355911097/gatewayapp/Hw/trunk/Project/Readme.Txt

2015-8-10 Rev1.00:   建立版本
2015-8-30 Rev2.00:   

1.修改为4通道电池
2.修正了采样sch错误的bug

2016-1-22 Rev2.01
修正1117引脚封装错位的问题
修正mos驱动电路增加IO的上拉电阻

V3.00
主控芯片换成MSP430
电源芯片采用升降压的TPS63000
电流采样采用INA213，降低测量时候的电压损耗

V3.10
修改Lux接口为数字接口
增加硬件看门狗

V4.00
充放电抽象出独立的板 3043-1-1550
修改Lux接口接插件为1.0间距，为了方便加工线缆
修改EEPROM的地址0xA0为0xA4
增加SPIFLASH接口
修改P2接插件
增加模拟Lux接口
