355911097/gatewayapp/doc/物联网网关/神州金山--物联网网关--产品测试任务书.docx

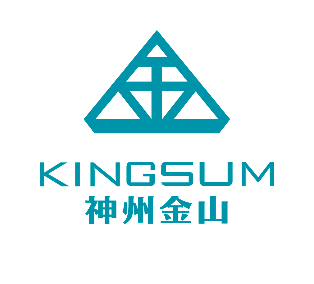
[picture p1: figure]

| 神州金山 技术文档 | 文件编号：SZJS-TEC-ZD-1708-001 页数： 版本：

消防物联网技术方案

拟制 | 王中亚 | 日期 | 2017/3/5
评审 | | 日期
批准 | | 日期

神州金山物联网科技（上海）有限公司

以上信息解释权归神州金山所有 | 打印件及电子版不受控，同效力使用

修订记录

日期 | 修订版本 | 编号 | 修改章节 | 修改内容 | 作者

# 目录

# 1 概述

消防物联网网关是一种远程监控、远程控制和数据采集的单元装置，它将成为消防的一些终端设备与互联网的通信纽带，将传统消防的人工监控控制转变为平台监控控制。消防主机、传感器、消防风机、水泵等消防设接入到消防物联网网关，物联网网接入到平台，可以实现通过平台监控各个设备的状态，并实现远程控制。

# 2 背景

# 3 主要技术指标

## 3.1 硬件配置

## 3.2 机械规格

外壳防护试验要求达到IEC60529机箱防护等级规定的IP54。

## 3.3 环境

- 温度和湿度
- 运行 -35℃ ~ +55℃温度

0 ~ 90% 湿度

- 存储 -35℃ ~ +70℃温度

0 ~ 90% 湿度

- 冲击和震动
- 冲击 半正弦波，50g，方向：X、Y、Z
- 震动 2~100Hz，7m/s² ，方向：X、Y、Z

## 3.4 网关和服务器通信

- 响应延迟：≤0.5s
- 数据包大小：≤512bytes
- 数据包间隔：≥0.5s

# 4 硬件环境

# 5 软件环境

Keil_V5.1

+Micrium_STM3220G-Eval_uCOS-III

+STM32F2xx_StdPeriph_Lib_V1.1.0库

+STM32F2x7_ETH_Driver_V1.1.0

+LWIP_V2.3

+C语言

## 5.1 Keil

Keil C51是美国Keil Software公司出品的51系列兼容单片机C语言软件开发系统，与汇编相比，C语言在功能上、结构性、可读性、可维护性上有明显的优势，因而易学易用。Keil提供了包括C编译器、宏汇编、链接器、库管理和一个功能强大的仿真调试器等在内的完整开发方案，通过一个集成开发环境（μVision）将这些部分组合在一起。运行Keil软件需要WIN98、NT、WIN2000、WINXP等操作系统。如果你使用C语言编程，那么Keil几乎就是你的不二之选，即使不使用C语言而仅用汇编语言编程，其方便易用的集成环境、强大的软件仿真调试工具也会令你事半功倍

## 5.2 Micrium_STM3220G-Eval_uCOS-III

uC/OS-III(Micro C OS Three 微型的C 语言编写的操作系统第3版)是一个可升级的，可固化的，基于优先级的实时内核。它对任务的个数无限制。uC/OS-III 是一个第3 代的系统内核，支持现代的实时内核所期待的大部分功能。例如资源管理，同步，任务间的通信等等。然而，uC/OS-III 提供的特色功能在其它的实时内核中是找不到的，比如说完备的运行时间测量性能，直接地发送信号或者消息到任务，任务可以同时等待多个内核对象等

## 5.3 STM32F2xx_StdPeriph_Lib_V1.1.0

STM32官方提供的关于STM32F2xx系列微控制器的外设固件函数库。该函数库是一个固件函数包，它由程序、数据结构和宏组成，包括了微控制器所有外设的性能特征。该函数库还包括每一个外设的驱动描述和应用实例。通过使用本固件函数库，无需深入掌握细节，用户也可以轻松应用每一个外设。因此，使用本固态函数库可以大大减少用户的程序编写时间，进而降低开发成本。

## 5.4 STM32F2x7_ETH_Driver_V1.1.0

STM32F2x7_ETH_ _V 是LwIP公司提供关于STM32F2xx系统微控制器的Light Weight (轻型)IP协议，有无操作系统的支持都可以运行。LwIP实现的重点是在保持TCP协议主要功能的基础上减少对RAM 的占用，它只需十几KB的RAM和40K左右的ROM就可以运行，这使LwIP协议栈适合在低端的嵌入式系统中使用。

## 5.5 LWIP_V2.3

STM32F2x7_ETH_ _V 是LwIP公司提供关于STM32F2xx系统微控制器的Light Weight (轻型)IP协议，有无操作系统的支持都可以运行。LwIP实现的重点是在保持TCP协议主要功能的基础上减少对RAM 的占用，它只需十几KB的RAM和40K左右的ROM就可以运行，这使LwIP协议栈适合在低端的嵌入式系统中使用。

# 6 设计方案

## 6.1 设计思想及原理

## 6.2 硬件设计

## 6.3 软件设计

物联网网关系统分为三个程序，一个是BootLoader程序，一个Downloader程序，一个是应用程序。

### 6.3.1 升级方式

### 6.3.2 系统运行流程图

### 6.3.3 BootLoader程序

BootLoader程序负责跳转，正常情况下会跳转到APP程序，当需要下载程序的时候会跳转到Downloader程序。

### 6.3.4 DownLoader程序

Downloader程序是用来下来APP程序，当我们需要更新APP程序的时候，Downloader程序会从平台把APP程序下载下来，校验成功后会执行更新，把之前的APP程序替换掉。

### 6.3.5 APP程序

APP程序为物联网网关的主程序，主要负责网关需求上面的全部功能。

### 6.3.6 FLASH分区

针对FLASH分三个区，一个区用来存放BootLoader程序，一个区用来存放下载程序，一个用来存放应用程序。

### 6.3.7 通信方式

#### 6.3.7.1 网关和平台通信方式

网关的数据传输可以通过无线方式和有线方式，网关集成了GPRS和Ethernet接口，网关可以接入到Internet网络，可以把数据传输到平台。

#### 6.3.7.2 网关和消防设备的通信方式

每个网关都会有多路RS485接口和RS232接口，不同多个消防设备可以通过RS485或RS232连接到一个网关，网关和消防设备之间的数据交互通过RS485或RS232。每个消防的设备的通信协议不同，网关要支持多种通信协议。

#### 6.3.7.3 通信协议

### 6.3.8 网关和平台通信协议

# 7 成本核算

请参照物料 KS-WL-WG-04-01.xlsx

# 8 测试

测试分为四个部分，外观测试、性能测试、整机测试和单元测试

## 8.1 外观测试

## 8.2 性能测试

## 8.3 整机测试

## 8.4 单元测试

# 9 调试和维护

神州金山物联网科技（上海）有限公司
