355911097/gatewayapp/doc/物联网网关/xxxxx技术方案模板.docx

| 神州金山 技术文档 | 文件编号：SZJS-TEC-ZD-1708-001 页数： 版本：

路灯RTU技术方案

拟制 | 王中亚 | 日期 | 2017/3/5
评审 | | 日期
批准 | | 日期

神州金山物联网科技（上海）有限公司

以上信息解释权归神州金山所有 | 打印件及电子版不受控，同效力使用

修订记录

日期 | 修订版本 | 编号 | 修改章节 | 修改内容 | 作者

# 目录

# 1 概述

# 2 背景

神州金山物联网科技（上海）有限公司
