355911097/gatewayapp/doc/物联网网关/神州金山--产品--系统分析.docx

| 神州金山 技术文档 | 文件编号：SZJS-TEC-ZD-1708-001 页数： 版本：

系统分析说明

拟制 | 王中亚 | 日期 | 2017/3/5
评审 | | 日期
批准 | | 日期

神州金山物联网科技（上海）有限公司

以上信息解释权归神州金山所有 | 打印件及电子版不受控，同效力使用

修订记录

日期 | 修订版本 | 编号 | 修改章节 | 修改内容 | 作者

# 目录

# 1 系统分析

## 1.1 系统初步了解

## 1.2 系统可行性分析

## 1.3 可拓展性分析

## 1.4 系统复杂性分析

- 逻辑功能
- 层次关系

## 1.5 产品维护分析

神州金山物联网科技（上海）有限公司
