355911097/gatewayapp/Hw/tags/V1.00/Project/Readme.Txt

2015-8-10 Rev1.00:   建立版本
2015-8-30 Rev2.00:   

1.修改为4通道电池
2.旁路切换改为photoMos
3.修正了采样sch错误的bug

2015-9-1 Rev3.00:
1.修改了电池电压采样电路为独立ADC+光电隔离模式
2.增加采样电源电压基准
3.更加分压网络，适应不同的电池电压。
4.修正了电池供电时候因为1117压降太大导致3.3V不足的bug。改用BUCK电路。

发现的问题：
1.ChargeCtrl的两根控制信号线忘记引出。
2.TLP2108接线错误
