355911097/gatewayapp/doc/物联网网关/其他/需求分析.png

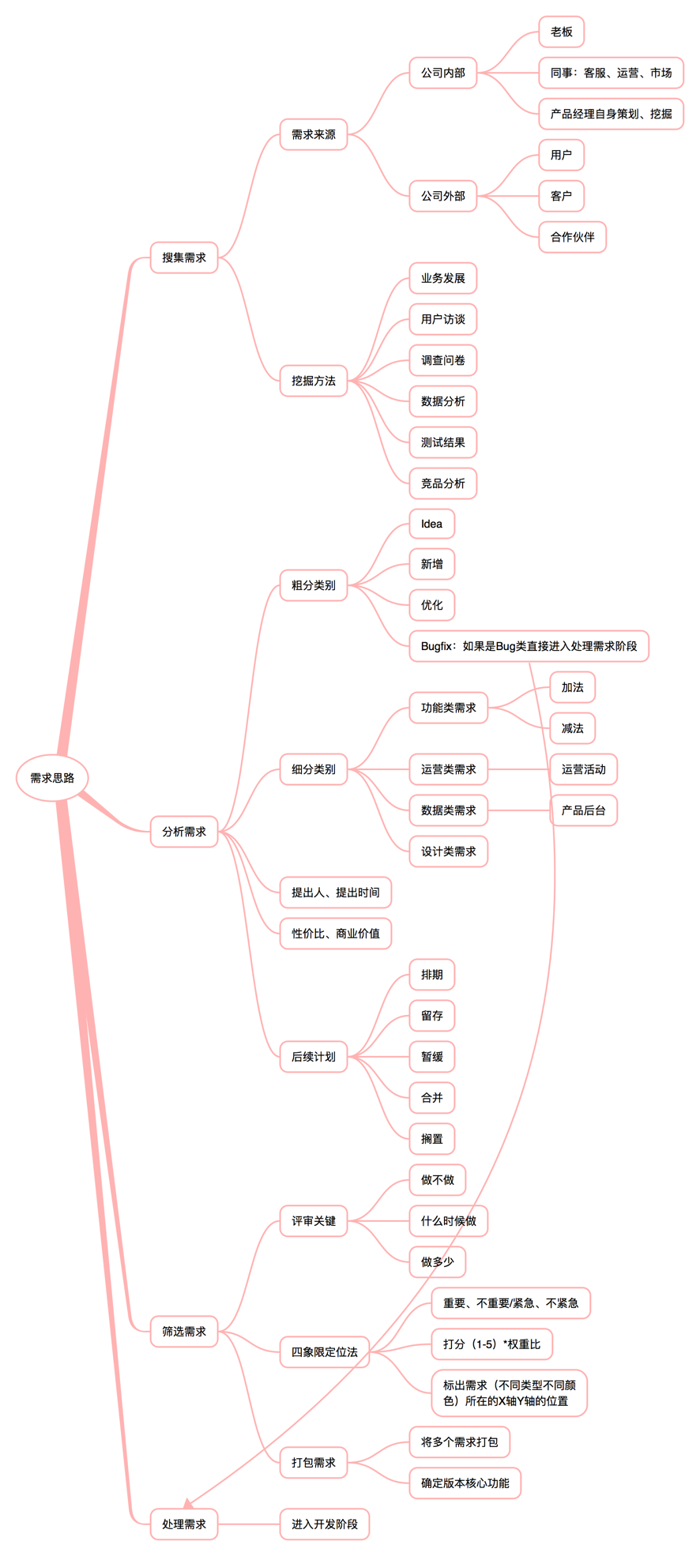
doc/物联网网关/其他/需求分析.png
