355911097/gatewayapp/doc/物联网网关/物料/BM-ETH-IOT.xls

Sheet: GPRS_IOT_1.4
项目名称 | GPRS_IOT_1.4
序号 | 规格 | 安装位置 | 封装 | 单板用量 | 价格
1.1 | 控器贴片
1.1.01 | 贴片铝电解电容[220uF/16V] | CE1，CE2，CE4，CE5，CE6 | 6.3*7.7mm | 5
1.1.02 | 贴片电容[22uF/6.3V/0805/X5R] | C9，C13，C35，C36 | 0805 | 4
1.1.03 | 贴片电容[10uF/10V/0805/X5R] | C1，C18，C25，C32，C33，C40，C41，C49，C50 | 0805 | 9
1.1.04 | 贴片电容[2.2uF/16V/0603/X7R] | C51 | 0603 | 1
1.1.05 | 贴片电容[1uF/16V/0603/X5R] | C10，C14 | 0603 | 2
1.1.06 | 贴片电容[100nF/16V/0603/X7R] | C2，C11，C15，C17，C21，C22，C23，C24，C26，C27，C37，C38，C39，C42，C44，C52 | 0603 | 16
1.1.07 | 贴片电容[10nF/50V/0603] | C46，C47，C48 | 0603 | 3
1.1.08 | 贴片电容[2.7nF/0603] | C34 | 0603 | 1
1.1.09 | 贴片电容[330pF/0603] | C12，C16 | 0603 | 2
1.1.10 | 贴片电容[33pF/0603] | C3，C4，C5，C6 | 0603 | 4
1.1.11 | 贴片电容[22pF/0603] | C7，C8，C30，C31 | 0603 | 4
1.1.12 | 贴片电容[10pF/0603] | C28，C29 | 0603 | 2
1.1.13 | 贴片LED/绿色/0603 | D1，D5 | 0603 | 2
1.1.14 | 贴片LED/红色/0603 | D2，D4 | 0603 | 2
1.1.15 | 贴片磁珠[GZ1608D121TF] | L3，L4，L6 | 0603 | 3
1.1.16 | 贴片功率电感[4.7uH] | L5 | 5845 | 1
1.1.17 | 贴片电阻[1M/0603/±5%] | R53 | 0603 | 1
1.1.18 | 贴片电阻[470K/0603/±1%] | R39，R40 | 0603 | 2
1.1.19 | 贴片电阻[180K/0603/±1%] | R51 | 0603 | 1
1.1.20 | 贴片电阻[100K/0603/±1%] | R2，R3，R24，R29，R54 | 0603 | 5
1.1.21 | 贴片电阻[91K/0603/±1%] | R25 | 0603 | 1
1.1.22 | 贴片电阻[47K/0603/±1%] | R9，R16，R34，R35，R36，R38 | 0603 | 6
1.1.23 | 贴片电阻[24K/0603/±1%] | R26 | 0603 | 1
1.1.24 | 贴片电阻[16K/0603/±1%] | R50 | 0603 | 1
1.1.25 | 贴片电阻[10K/0603/±1%] | R5，R6，R14，R15，R17，R19，R20，R21，R55，R62 | 0603 | 10
1.1.26 | 贴片电阻[5.6K/0603/±1%] | R58 | 0603 | 1
1.1.27 | 贴片电阻[4.7K/0603/±1%] | R10，R11，R22 | 0603 | 3
1.1.28 | 贴片电阻[3K/0603/±1%] | R8 | 0603 | 1
1.1.29 | 贴片电阻[2K/0603/±1%] | R61 | 0603 | 1
1.1.30 | 贴片电阻[1K/0603/±1%] | R23，R27，R28，R52，R59 | 0603 | 5
1.1.31 | 贴片电阻[510R/0603/±1%] | R60 | 0603 | 1
1.1.32 | 贴片电阻[470R/0603/±1%] | R1 | 0603 | 1
1.1.33 | 贴片电阻[300R/0603/±1%] | R7 | 0603 | 1
1.1.34 | 贴片自恢复保险丝1.1A | F1 | 1812 | 1 | 3
1.1.35 | 贴片32.768K无源晶振[2脚] | Y1 | SMD-2*6 | 1 | 1
1.1.36 | 贴片25M无源晶振[4脚/3225] | Y2 | 3225 | 1 | 3
1.1.37 | 贴片四脚轻触按键[ 6*6*5mm] | SW1 | KEY-6*6 SMD | 1 | 0.2
1.1.38 | TF卡座 翻盖式 | J7 | TF-Card | 1 | 0.4
1.1.39 | 翻盖式6脚SIM卡座 | J1 | SIM_Card | 1 | 1
1.1.40 | 贴片天线座子[IPEX/IPX接头 U.FL-R-SMT] | J2 | IPEX | 1 | 2+5
1.1.41 | NMOS[2N7002] | Q1，Q2，Q3，Q6 | SOT-23 | 4
1.1.42 | PMOS[AO3401A] | Q5 | SOT-23 | 1
1.1.43 | 电压基准[TL431AIDBZR] | N1 | SOT-23 | 1
1.1.44 | 肖特基二极管[BAT54C] | D3 | SOT-23 | 1
1.1.45 | 肖特基二极管[BAT54A] | Q7 | SOT-23 | 1
1.1.46 | ESD保护二极管 [PESD3V3L5UV] | U1 | SOT-666 | 1 | 2
1.1.47 | 华为GSM&&GPRS模块MG301 | U2 | LCC-MG301 | 1 | 30
1.1.48 | 32位处理器[STM32F205RET6] | U3 | TQFP-64 | 1 | 20
1.1.49 | FLASH存储器[W25Q32JVSSIQ] | U4 | SOIC-8 | 1 | 2
1.1.50 | DC-DC芯片[RT7272B] | U5 | TSOT-23-8 | 1 | 1.5
1.1.51 | LDO[RT9193-33GB] | U6 | SOT23-5 | 1 | 0.3
1.1.52 | CR927 3V 纽扣电池 卧式 贴片 | BT1 | 2PIN | 1 | 18/50
 | 控器插件
1.2.01 | 2.54mm间距双排针插座2*10P | J3，J5 | HDR2X10 | 2 | 5
 |  |  |  |  | 69.4

Sheet: EXT_IO_CJ_1.3
项目名称 | EXT_IO_CJ_1.3
序号 | 规格 | 安装位置 | 封装 | 单板用量 | 编号
1.1 | 控器贴片
1.1.01 | 贴片电容[100uF/50V] | C2 | 8*10.5 | 1 | C3352
1.1.02 | 贴片电容[100uF/16V] | C4 | 6.3*5.4 | 1 | C72475
1.1.03 | 贴片电容[10uF/50V/1206/X5R] | C3 | 1206 | 1 | C13585
1.1.04 | 贴片电容[10uF/10V/0805/X5R] | C5，C6，C11，C12 | 0805 | 4 | C17024
1.1.05 | 贴片电容[100nF/16V/0603/X7R] | C1，C9，C10，C13 | 0603 | 4 | C66501
1.1.06 | 贴片电容[10nF/50V/0603] | C8，C14，C15，C16 | 0603 | 4 | C1589
1.1.07 | 贴片电容[2.7nF/0603] | C7 | 0603 | 1 | C1609
1.1.08 | 贴片电阻[180K/0603/±1%] | R2 | 0603 | 1 | C22827
1.1.09 | 贴片电阻[63.4K/0603/±1%] | R1 | 0603 | 1 | C23093
1.1.10 | 贴片电阻[24K/0603/±1%] | R6 | 0603 | 1 | C23352
1.1.11 | 贴片电阻[20K/0603/±1%] | R3，R16 | 0603 | 2 | C4184
1.1.12 | 贴片电阻[11.8K/0603/±1%] | R5 | 0603 | 1 | C22861
1.1.13 | 贴片电阻[10K/0603/±1%] | R4，R14 | 0603 | 2 | C25804
1.1.14 | 贴片电阻[10K/0805/±0.1%] | R18，R19 | 0805 | 2 | C55866
1.1.15 | 贴片电阻[4.7K/0603/±1%] | R13 | 0603 | 1 | C23162
1.1.16 | 贴片电阻[2.32K/0603/±1%] | R7，R8 | 0603 | 2 | C22905
1.1.17 | 贴片电阻[1K/0603/±1%] | R9，R10，R11，R12，R15 | 0603 | 5 | C21190
1.1.18 | 贴片LED/绿色/0603 | D14 | 0603 | 1 | C72042
1.1.19 | 贴片LED/红色/0603 | D13 | 0603 | 1 | C72045
1.1.20 | 贴片功率电感/6.8uH ±20% | L1 | 5845 | 1 | C10121
1.1.21 | NMOS[2N7002] | Q1，Q2 | SOT-23 | 2 | C8545
1.1.22 | NPN三极管[S8050] | Q3 | SOT-23 | 1 | C2146
1.1.23 | 贴片四脚轻触按键[ 6*6*5mm] | SW1 | KEY-6*6 SMD | 1 | C21456
1.1.24 | 贴片自恢复保险丝500mA | F1，F2 | 1206 | 2 | C20799 |  | 0.5
1.1.25 | 贴片自恢复保险丝100mA | F3，F4 | 1206 | 2 | C20981 |  | 0.5
1.1.26 | 肖特基二极管[SS34] | D1 | SMA(DO-214AC) | 1 | C8678
1.1.27 | 肖特基二极管[SS14] | D8，D9 | SOD-123F | 2 | C59293
1.1.28 | TVS瞬态[SMAJ26CA] | D2 | SMA(DO-214AC) | 1 | C56595
1.1.29 | TVS瞬态[SMAJ7.0CA] | D10，D11 | SMA(DO-214AC) | 2 | C34043
1.1.30 | 开关二极管[1N4148] | D6 | D1206 | 1 | C9808
1.1.31 | 稳压二极管3V[MMSZ4683 3V CJ] | D7，D12 | SOD-123 | 2 | C21512 |  | 0.5
1.1.32 | DC-DC芯片[RT7272B] | U1 | SOP-8 | 1 | 配单 |  | 1.5
1.1.33 | LDO/XC6206P302MR | U2 | SOT-23 | 1 | C9972 |  | 0.1
1.1.34 | 运放OPA2340UA | U4 | SOP-8 | 1 | 配单 |  | 8
 | 控器插件
1.2.01 | 继电器/G5LA-14-5VDC | LS1 | G5LA-14-5VDC | 1 | C27822 |  | 5
1.2.02 | PCB接线端子[WJ128V-5.0-2P ] | J1，J7 | 5.0-2P | 2 | C8268 |  | 1
1.2.03 | PCB接线端子[WJ128V-5.0-4P ] | J8 | 5.0-2P | 1 | C8268 | 备注4Pin的用连个2Ppin拼接 | 1
1.2.04 | PH连接器/PH-9A/直针 | J6 | 2MM-9P | 1 | C8878 |  | 1
1.2.05 | 2.54mm间距单排针 21mm高度 10p | J2，J3 | 10P | 2 | C51353 |  | 1
1.2.06 | RJ24高精密金属膜电阻低温票125R/0.1% | R17 | RJ24 | 1 | 淘宝 | https://item.taobao.com/item.htm?spm=a230r.1.14.3.Ea6p6h&id=523167336450&ns=1&abbucket=18#detail | 0.2
 |  |  |  |  |  |  | 20.3

Sheet: ETH_IOT_1.1
项目名称 | ETH_IOT_1.1
序号 | 规格 | 安装位置 | 封装 | 单板用量 | 编号
1.1 | 控器贴片
1.1.01 | 贴片电容[10uF/10V/0805/X5R] | C5，C7，C17，C18，C21，C22，C29，C34，C41，C43，C44，C57 | 0805 | 12 | C17024
1.1.02 | 贴片电容[100nF/16V/0603/X7R] | C1，C2，C3，C4，C6，C8，C9，C14，C15，C16，C19，C30，C31，C32，C33，C35，C36，C37，C42 | 0603 | 19 | C66501
1.1.03 | 贴片电容[10nF/50V/0603] | C23，C24 | 0603 | 2 | C1589
1.1.04 | 贴片电容[4.7nF/2KV/1206] | C40 | 1206 | 1 | C41017
1.1.05 | 贴片电容[22pF/0603] | C12，C13 | 0603 | 2 | C1653
1.1.06 | 贴片电容[10pF/0603] | C10，C11，C25，C26，C27，C28 | 0603 | 6 | C1634
1.1.07 | 贴片LED/绿色/0603 | D5 | 0603 | 1 | C72042
1.1.08 | 贴片LED/红色/0603 | D3，D4 | 0603 | 2 | C72045
1.1.09 | 贴片磁珠[GZ1608D121TF] | L1，L2，L3 | 0603 | 3 | C18527
1.1.10 | 贴片电阻[1M/0603/±5%] | R44 | 0603 | 1 | C26098
1.1.11 | 贴片电阻[470K/0603/±1%] | R29，R30 | 0603 | 2 | C23178
1.1.12 | 贴片电阻[100K/0603/±1%] | R27，R53 | 0603 | 2 | C25803
1.1.13 | 贴片电阻[47K/0603/±1%] | R5，R8，R9，R10，R11，R18 | 0603 | 6 | C25819
1.1.14 | 贴片电阻[12.4K/0603/±1%] | R43 | 0603 | 1 | C22865
1.1.15 | 贴片电阻[10K/0603/±1%] | R3，R4，R12，R14，R15，R16，R25，R31，R32，R42，R45，R46，R47，R48，R49 | 0603 | 15 | C25804
1.1.16 | 贴片电阻[4.7K/0603/±1%] | R6，R7，R17 | 0603 | 3 | C23162
1.1.17 | 贴片电阻[2.32K/0603/±1%] | R51 | 0603 | 1 | C22905
1.1.18 | 贴片电阻[2K/0603/±1%] | R21 | 0603 | 1 | C22975
1.1.19 | 贴片电阻[1K/0603/±1%] | R20，R22，R24，R52 | 0603 | 4 | C21190
1.1.20 | 贴片电阻[510R/0603/±1%] | R19，R38，R40，R41 | 0603 | 4 | C23193
1.1.21 | 贴片电阻[51R/0603/±1%] | R33，R34，R35，R36 | 0603 | 4 | C23197
1.1.22 | 贴片电阻[0R/0603/±1%] | R37，R39 | 0603 | 2 | C21189
1.1.23 | 贴片自恢复保险丝1.1A | F1 | 1812 | 1 | C69691 |  | 3
1.1.24 | 贴片32.768K无源晶振[2脚] | Y1 | SMD-2*6 | 1 | 配单 | https://item.taobao.com/item.htm?spm=a230r.1.14.78.lP9SPV&id=521527550939&ns=1&abbucket=18#detail | 1
1.1.25 | 贴片25M无源晶振[4脚/3225] | Y2 | 3225 | 1 | C9006 |  | 3
1.1.26 | 贴片四脚轻触按键[ 6*6*5mm] | SW1 | KEY-6*6 SMD | 1 | C21456
1.1.27 | 贴片天线座子[IPEX/IPX接头 U.FL-R-SMT] | J7 | IPEX | 1 | 配单 | https://detail.tmall.com/item.htm?id=43497770477&ali_trackid=1_e7d4de1175c1e061d4b41b17b0cd8ff4 | 0.2
1.1.28 | TF卡座 翻盖式 | J3 | TF-Card | 1 | C64205 |  | 0.4
1.1.29 | NMOS[2N7002] | Q1，Q2 | SOT-23 | 2 | C8545
1.1.30 | 电压基准[TL431AIDBZR] | U3 | SOT-23 | 1 | C23892
1.1.31 | 肖特基二极管[BAT54C] | D3 | SOT-23 | 1 | C37704
1.1.32 | 32位处理器[STM32F207VET6] | U3 | TQFP-100 | 1 | C59126 |  | 20
1.1.33 | FLASH存储器[W25Q32JVSSIQ] | U2 | SOIC-8 | 1 | C82344 |  | 2
1.1.34 | 以太网IC[LAN8720A-CP-TR] | U5 | QFN24 | 1 | C45223 |  | 3
1.1.35 | LDO[RT9193-33GB] | U4，U7 | SOT23-5 | 2 | C15651 |  | 0.5
1.1.36 | WIFI模块[WIFI_ESP-08S] | U6 | ESP-08S | 1 | 配单 | https://item.taobao.com/item.htm?spm=a230r.1.14.57.CG4CZX&id=536891267753&ns=1&abbucket=18#detail | 13
1.1.37 | CR927 3V 纽扣电池 卧式 贴片 | BT1 | 2PIN | 1 | 淘宝 | https://detail.1688.com/offer/521225211041.html?spm=b26110380.sw1688.0.0.zr7LHA | 0.6
 | 控器插件
1.2.01 | 2.54mm间距双排针插座2*10P | J1，J4 | HDR2X10 | 2 | C30867 |  | 5
1.2.02 | RJ45接口/卧式/带变压器[HR911105A] | J6 | CON12-RJ45 | 1 | C12074 |  | 5
 |  |  |  |  |  |  | 56.7

Sheet: EXT_IO_TX_1.5
项目名称 | EXT_IO_TX_1.5
序号 | 规格 | 安装位置 | 封装 | 单板用量 | 编号 | 价格
1.1 | 控器贴片
1.1.01 | 贴片电容[100uF/50V] | C5 | 8*10.2 | 1 | C3352
1.1.02 | 贴片电容[100uF/16V] | C2 | 6.3*5.4 | 1 | C72475
1.1.03 | 贴片电容[10uF/50V/1206/X5R] | C6 | 1206 | 1 | C13585
1.1.04 | 贴片电容[22uF/10V/0805/X5R] | C41，C42，C44，C45 | 0805 | 4 | C29277
1.1.05 | 贴片电容[10uF/10V/0805/X5R] | C3，C4，C10，C16，C52 | 0805 | 5 | C17024
1.1.06 | 贴片电容[100nF/16V/0603/X7R] | C1，C9，C12，C14，C15，C17，C18，C19，C20，C21，C32，C33，C34，C40，C43，C51，C53 | 0603 | 17 | C66501
1.1.07 | 贴片电容[10nF/50V/0603] | C49，C50 | 0603 | 2 | C1589
1.1.08 | 贴片电容[2.7nF/0603] | C7 | 0603 | 1 | C1609
1.1.09 | 贴片LED/绿色/0603 | D5，D12 | 0603 | 2 | C72042
1.1.10 | 贴片LED/红色/0603 | D4，D20 | 0603 | 2 | C72045
1.1.11 | 贴片电阻[180K/0603/±1%] | R2 | 0603 | 1 | C22827
1.1.12 | 贴片电阻[64.9K/0603/±1%] | R3 | 0603 | 1 | C14891
1.1.13 | 贴片电阻[24K/0603/±1%] | R5 | 0603 | 1 | C23352
1.1.14 | 贴片电阻[20K/0603/±1%] | R1 | 0603 | 1 | C4184
1.1.15 | 贴片电阻[11.8K/0603/±1%] | R4 | 0603 | 1 | C22861
1.1.16 | 贴片电阻[10K/0603/±1%] | R13，R30，R50，R51，R55，R56 | 0603 | 6 | C25804
1.1.17 | 贴片电阻[5.1K/0603/±1%] | R53 | 0603 | 1 | C4247
1.1.18 | 贴片电阻[4.7K/0603/±1%] | R11 | 0603 | 1 | C23162
1.1.19 | 贴片电阻[3K/0603/±1%] | R14 | 0603 | 1 | C4211
1.1.20 | 贴片电阻[2.32K/0603/±1%] | R7 | 0603 | 1 | C22905
1.1.21 | 贴片电阻[1.5K/0603/±1%] | R6 | 0603 | 1 | C22843
1.1.22 | 贴片电阻[1K/1206/±1%] | R31 | 1206 | 1 | C4410
1.1.23 | 贴片电阻[1K/0603/±1%] | R8，R9，R10，R12，R17，R18，R20，R22，R27，R29，R34，R52，R54 | 0603 | 13 | C21190
1.1.24 | 贴片电阻[510R/0603/±1%] | R23，R28 | 0603 | 2 | C23193
1.1.25 | 贴片电阻[240R/0805/±1%] | R15 | 0805 | 1 | C17572
1.1.26 | 贴片电阻[0R/0603/±5%] | R19 | 0603 | 1 | C21189
1.1.27 | 贴片功率电感/6.8uH ±20% | L1 | 5845 | 1 | C10121
1.1.28 | 贴片功率电感/4.7uH ±20% | L2 | 5845 | 1 | C14258
1.1.29 | NMOS[2N7002] | Q1，Q2 | SOT-23 | 2 | C8545
1.1.30 | 贴片四脚轻触按键[ 6*6*5mm] | SW1 | KEY-6*6 SMD | 1 | C21456
1.1.31 | 贴片自恢复保险丝500mA | F1 | 1206 | 1 | C20799 | 3
1.1.32 | 肖特基二极管[SS34] | D1，D13，D14 | SMA(DO-214AC) | 3 | C8678
1.1.33 | TVS瞬态[SMAJ26CA] | D2 | SMA(DO-214AC) | 1 | C56595
1.1.34 | TVS瞬态[SMBJ18CA] | D6，D7，D8，D9 | SMB(DO-214AA) | 4 | C8800
1.1.35 | 稳压二极管[MMSZ5242B 12V] | D3 | SOD-123 | 1 | C21567
1.1.36 | 二极管[BAT54C] | D21 | SOT-23 | 1 | C37704
1.1.37 | 二极管[BAT54A] | Q3 | SOT-23 | 1 | C8591
1.1.38 | DC-DC芯片[RT7272B] | U1 | SOP-8 | 1 | 配单 | 1.5
1.1.39 | 电池管理芯片[TP5410] | U25 | SOP-8 | 1 | C79927 | 1
1.1.40 | 贴片光耦[EL357N(C)(TA)-G] | U3 | SOP-4 | 1 | C29981
1.1.41 | 贴片光耦[6N137S(TA)] | U4，U6，U8 | SMD-8_6.3mm | 3 | C16496
1.1.42 | 接口芯片[MAX13487EESA] | U7 | SOP-8 | 1 | C18347 | 3
1.1.43 | 接口芯片[MAX202EESE+T] | U5 | SOP-16 | 1 | C9947 | 4
 | 控器插件
1.2.01 | XH2.54端子[XH-2A] | BT2 | 2.54MM-2 | 1 | C20079 | 0.2
1.2.02 | PCB接线端子[WJ128V-5.0-3P ] | J8 | 5.0-3P | 1 | C8270 | 1
1.2.03 | PCB接线端子[WJ128V-5.0-2P ] | J1，J5，J7 | 5.0-2P | 3 | C8268 | 1
1.2.04 | PH连接器/PH-9A/直针 | J6 | 2MM-9P | 1 | C8878 | 0.5
1.2.05 | 2.54mm间距单排针 21mm高度 10p | J2，J4 | 10P | 2 | C51353 | 1
1.2.06 | 直插0.12A 250V 自恢复型保险丝 | F2，F3，F4，F5 | RL250-120 | 4 | C21035 | 1
1.2.07 | 隔离电源模块/B0505S-1WR2 | U2 | SIP-4 | 1 | C18424 | 7
 |  |  |  |  |  | 24.2
