355911097/gatewayapp/doc/物联网网关/物料/KS-WL-WG-04-01.xlsx

Designator | Quantity | Comment | Footprint | Mfr_PN | Manufacturer | Part Description | Note | 价格
B700 | 1 | 120R | 0603 RES | BLM18PG121SN1D | MURATA | Bead, Power, 1000mA, CHIP, SURFACE MOUNT,120R, 0.05R
C100, C101, C113, C114, C115, C116, C117, C217, C218, C323, C326, C508, C511, C512, C515, C600, C706, C711, C801, C804, C805 | 21 | 10uF | C0805 | GRM219R61E475KA73 | MURATA | CAPACITOR, CERAMIC CHIP, 0805 CASE, SURFACE MOUNT , 10 uF +/-10% 25 V, X5R
C102, C104, C107, C111, C202, C203, C206, C207, C208, C209, C210, C211, C212, C213, C214, C215, C216, C220, C304, C305, C306, C307, C316, C317, C319, C320, C321, C322, C324, C325, C327, C328, C329, C401, C402, C403, C404, C405, C406, C407, C408, C409, C411, C413, C415, C500, C501, C502, C503, C504, C505, C506, C507, C509, C510, C513, C514, C516, C517, C518, C519, C601, C613, C619, C705, C707, C708, C709, C710, C712, C800, C802, C803 | 73 | 0.1uF | 0402 CAP | GRM155R61E104KA87 | MURATA | CAPACITOR, CERAMIC CHIP, 0402 CASE, SURFACE MOUNT , 0.1 uF +/-20% 25 V, X7R
C103, C318, C400 | 3 | 10uF | C1206_L | GRM31CR61H106KA12L | MURATA | CAPACITOR, CERAMIC CHIP, 1206 CASE, SURFACE MOUNT , 10uF +/-20% 25V, X5R
C105, C106, C112 | 3 | 47uF | C1206 | GRM31CR61A476ME15 | MURATA | CAPACITOR, CERAMIC CHIP, 1206 CASE, SURFACE MOUNT , 47 uF +/-20% 10 V, X5R
C108, C609, C610, C611, C615, C616 | 6 | 220uF | LC-CASE-B_3528 | TC212B227M006A | Sunlord | CAP, Tan, 100uF 6V3 10% 105c, 4-10Khr Life, Hi Ripple, Low Imped
C109 | 1 | 120pF | 0402 CAP | GRM1555C1H121JA01 | MURATA | CAPACITOR, CERAMIC CHIP, 0402 CASE, SURFACE MOUNT , 120 pF +/-5% 50 V, C0G
C110 | 1 | 15nF | 0402 CAP | GRM1555C1H153JA01 | MURATA | CAPACITOR, CERAMIC CHIP, 0402 CASE, SURFACE MOUNT , 15 nF +/-5% 50 V, C0G
C200, C201 | 2 | 12pF | 0402 CAP | GRM1555C1H120JA01 | MURATA | CAPACITOR, CERAMIC CHIP, 0402 CASE, SURFACE MOUNT , 12 pF +/-5% 50 V, C0G
C204, C205 | 2 | 18pF | 0402 CAP | GRM1555C1H180JA01 | MURATA | CAPACITOR, CERAMIC CHIP, 0402 CASE, SURFACE MOUNT , 18 pF +/-5% 50 V, C0G
C219 | 1 | 0.2F | RTC Cap | C122504 | STARCAP | 3V3, 0.2F
C300, C301, C302, C303 | 4 | 4.7uF | C0805 | GRM219R61E475KA73 | MURATA | CAPACITOR, CERAMIC CHIP, 0805 CASE, SURFACE MOUNT , 2.2 uF +/-10% 25 V, X5R
C308, C309, C310, C311, C312, C313, C314, C315 | 8 | 1000pF | 0402 CAP | GRM1555C1H102JA01 | MURATA | CAPACITOR, CERAMIC CHIP, 0402 CASE, SURFACE MOUNT , 1000 pF +/-5% 50 V, C0G
C330, C410, C412, C414, C416, C612, C618 | 7 | 1uF | C0805 | CC0805K_X7R9BB106 | Yageo | CAPACITOR, CERAMIC CHIP, 0805 CASE, SURFACE MOUNT , 1uF +/-10% 50 V, X7R
C602, C603, C604, C605 | 4 | 33pF | 0402 CAP | GRM1555C1H330JA01 | MURATA | CAPACITOR, CERAMIC CHIP, 0402 CASE, SURFACE MOUNT , 33 pF +/-5% 50 V, C0G
C606 | 3 | 47pF | 0402 CAP | GRM1555C1H470JA01 | MURATA | CAPACITOR, CERAMIC CHIP, 0402 CASE, SURFACE MOUNT , 47 pF +/-5% 50 V, C0G | C622，C623 不贴
C607, C608, C624, C625, C626, C627, C713, C714 | 8 | NC | 0402 CAP | NC | MURATA | CAPACITOR, CERAMIC CHIP, 0402 CASE, SURFACE MOUNT ,NC | 不贴
C614, C620 | 2 | 330pF | 0402 CAP | GRM1555C1H331JA01 | MURATA | CAPACITOR, CERAMIC CHIP, 0402 CASE, SURFACE MOUNT , 330 pF +/-5% 50 V, C0G
C617, C621 | 2 | 22uF | C1206_L | GRM31CR61E226ME15 | MURATA | CAPACITOR, CERAMIC CHIP, 1206 CASE, SURFACE MOUNT , 22uF +/-20% 25V, X5R
C700, C701, C702, C703 | 4 | 10pF | 0402 CAP | GRM1555C1H100JA01 | MURATA | CAPACITOR, CERAMIC CHIP, 0402 CASE, SURFACE MOUNT , 10 pF +/-5% 50 V, C0G
C704 | 1 | 0.01uF | 0402 CAP | GRM155R71H103KA88 | MURATA | CAPACITOR, CERAMIC CHIP, 0402 CASE, SURFACE MOUNT , 0.01 uF +/-10% 50 V, X7R
C715 | 1 | 47nF | C1206 | GRM31M5C1H473JA01# | MURATA | CAPACITOR, CERAMIC CHIP, 1206 CASE, SURFACE MOUNT , 47 nF +/-5% 50 V, C0G
D101, D102 | 2 | Designator | LC-SMB(DO-214AA)_S5 | SS310 | DIODES | DIODE, Schottky, 100V, 3A, 0.74V
D200, D201, D202, D204, D205, D206 | 6 | GRN | led 257 | 2A5G3HD01 | Kento | LED, 2x5x7, 2.28
D203, D308, D309, D310, D311, D402, D403, D404, D405 | 9 | 0.3A | SOT-23-3 | BAT54S | JCST | SOT-23-3, 30V,200mA, Serial A K
D300, D301, D302, D303 | 4 | 3A | OJ | OJE-SS-112LM | TE | Relay OJE 3A, VAC277, VDC 30V, Coil 12V, 320R, 450mW
D304, D305, D306, D307 | 4 | 1N4148W | SOD123 | 1N4148W | DIODES | DIODE, Signal, 75V 150mA SOD-123
D312, D313, D314, D315, D318, D319, D320, D321 | 8 | MM3Z12V | LC-SOD-323 | MM3Z12V | EIC | Zener, 12V, 300 mW, SOD-323
D316, D317, D322, D323, D328, D329, D334, D335 | 8 | LTV817S | TLV817S | LTV817S | LiteON | Photo coupler,Vceo30V,Ic50mA,ISO5000Vrms
D324, D325, D326, D327, D330, D331, D332, D333 | 8 | 8kV | 0402 ESD | LXES15AAA1 | Murata | 8kV, 0.05pF, <0.1ns
D336, D337, D338, D339, D340, D341, D342, D343, D344, D345, D346, D347 | 12 | 2N7002 | SOT-23-3 | 2N7002 | TI | +60V 115mA, NMOS, 7OHm at 5V
D400, D409, F313 | 3 | 26V | LC-SMB(DO-214AA)_S5 | SMBJ26A | Littelfuse | SMB, 26V, 600W
D401 | 1 | TL431 | SOT-23-3 | TL431 | SK | Adjustable Accurate Reference Source
D406, D407, D408 | 3 | 5V | LC-SMB(DO-214AA)_S5 | SMBJ5A | Littelfuse | SMB, 5V, 600W
D410 | 1 | MMBT4403 | PNP | MMBT4403 | DOIDES | PNP Transistor, MMBT4403
D411 | 1 | SI2301 | SOT23_N | SI2301 | Micro Commercial Components | -20V -2.8A, PMOS, SOT23
D500, D501 | 2 | 0.3A | SOT-23-3 | BAT54A | JCST | TO-236, 30V,200mA, Comm A
D502, D503, D504, D505, D506, D507, D508, D509 | 8 | 18V | LC-SMB(DO-214AA)_S5 | SMBJ18CA | Littelfuse | SMB, 18V, 600W, Bidirectional
D600 | 1 | PESD3V3L5UV | SOT-666 | PESD3V3L5UV | NXP | Low capacitance 5-fold ESD protection diode arrays in SOT666 package
F100 | 1 | FUSE-SOCKET 20X5.2 | FUSE Socket | FUSE-SOCKET 20X5.2 | Belfuse | Fuse, Socket, 20X5.2, 6A, 250Vac
F300, F301, F302, F303 | 4 | 3A 250VAC | FUSE 36X100 | 3A 250VAC | Littelfuse | 3.6X10mm, 250VAC， fuse, 3A
F304, F305, F306, F307, F308, F309, F310, F311, F312, F400, F402, F403, F406, F407, F500, F501, F502, F503, F504, F505, F506, F507 | 22 | 1206L025YR | 1206_FUSE | 1206L025YR | Littelfuse | 1206 Fuse 0.25A
L100 | 1 | 15 uH | IND 100x100 | SLF10145T-150M2R2-PF | TDK | INDUCTOR, Power, 2200mA, CHIP, WIREWOUND, SURFACE MOUNT , 15 UH +/-20%
L101 | 1 | 4.7uH | IND 50X40 | SWPA5040S4R7MT | TDK | INDUCTOR, Power, 3500mA, CHIP, WIREWOUND, SURFACE MOUNT , 2.2 UH +/-20%
P100, P400, P401 | 3 | Kingsum-CONN-15EDG 3X2 | 15EDG-3x2 lock | 15EDGKDM-3.81-3P Set | 奥斯电子有限公司 | Header 15EDG Right angle 3.81mm 2X3P
P101 | 1 | Kingsum-SWITCH-AC-Panel | XW-601AB1 | XW-601AB1 |  | SWITCH-AC-Panel
P102 | 1 | Kingsum-CONN-XH-2AWD | XH-2AWD | XH-2AWD | BOOM | Header 2.54mm 1*2P Right angle
P300, P301, P500 | 3 | Kingsum-CONN-15EDG 5X2 | 15EDG-5x2 LOCK | 15EDGKDM-3.81-5P Set | 奥斯电子有限公司 | Header 15EDG Right angle 3.81mm 2X5P
P600 | 3 | ADE-CONN-RF-IPX | IPX | 734120110 | Molex | IPX 50Ohm,MCRF,PCB Vertical Jack Receptacle, SMT,1.25 mm Height | P601, P602不贴
P800 | 1 | ADE-CONN-Header 5 | HDR1X5 | 1-829487-0 | TE | Header 2.54mm 5P
P801 | 1 | ADE-CONN-Header 10 | HDR1X10 | 1-829487-0 | TE | Header 2.54mm 10P
P802 | 1 | ADE-CONN-Header 12 | HDR1X12 | 1-829487-0 | TE | Header 2.54mm 12P
R100 | 1 | 28K | 0402 Res | RC0402JR-7D28KL | YAGEO | RESISTOR, CHIP, THICK FILM, SURGE CURRENT, 0402 CASE, 1/16 W, 50 V , 28K OHMS +/-5%, +/-100 PPM/DEG C, TIN TERMINATION
R101, R412, R605 | 3 | 3K | 0402 Res | RC0402FR-073KL | YAGEO | RESISTOR, CHIP, THICK FILM, SURGE CURRENT, 0402 CASE, 1/16 W, 50 V , 3K OHMS +/-1%, +/-100 PPM/DEG C, TIN TERMINATION
R102, R702, R703, R704, R705 | 5 | 51R | 0402 Res | RC0402JR-7D51RL | YAGEO | RESISTOR, CHIP, THICK FILM, SURGE CURRENT, 0402 CASE, 1/16 W, 50 V , 51 OHMS +/-5%, +/-100 PPM/DEG C, TIN TERMINATION
R103 | 1 | 200K 1% | 0402 Res | RC0402FR-7D200KL | YAGEO | RESISTOR, CHIP, THICK FILM, SURGE CURRENT, 0402 CASE, 1/16 W, 50 V , 20K OHMS +/-5%, +/-100 PPM/DEG C, TIN TERMINATION
R104, R303, R602, R607 | 4 | 100K | 0402 Res | RC0402JR-7D100KL | YAGEO | RESISTOR, CHIP, THICK FILM, SURGE CURRENT, 0402 CASE, 1/16 W, 50 V , 100K OHMS +/-5%, +/-100 PPM/DEG C, TIN TERMINATION
R105 | 1 | 3K74 | 0603 RES | RC0603FR-073K74L | YAGEO | RESISTOR, CHIP, THICK FILM, SURGE CURRENT, 0402 CASE, 1/16 W, 50 V , 3K74 OHMS +/-1%, +/-100 PPM/DEG C, TIN TERMINATION
R106 | 1 | 143K | 0402 Res | RC0402JR-7D169KL | YAGEO | RESISTOR, CHIP, THICK FILM, SURGE CURRENT, 0402 CASE, 1/16 W, 50 V , 169K OHMS +/-5%, +/-100 PPM/DEG C, TIN TERMINATION
R107, R110, R116, R117, R121, R123, R124, R200, R201, R202, R203, R204, R205, R206, R207, R208, R210, R211, R308, R309, R310, R311, R316, R317, R318, R319, R324, R325, R326, R327, R332, R333, R334, R335, R401, R407, R500, R501, R505, R506, R603, R606, R700, R701 | 44 | 10K | 0402 Res | RC0402JR-7D10KL | YAGEO | RESISTOR, CHIP, THICK FILM, SURGE CURRENT, 0402 CASE, 1/16 W, 50 V , 10K OHMS +/-5%, +/-100 PPM/DEG C, TIN TERMINATION
R108, R209, R212 | 3 | 47K 1% | 0402 Res | RC0402FR-7D47KL | YAGEO | RESISTOR, CHIP, THICK FILM, SURGE CURRENT, 0402 CASE, 1/16 W, 50 V , 20K OHMS +/-5%, +/-100 PPM/DEG C, TIN TERMINATION
R109 | 1 | 20K 1% | 0402 Res | RC0402FR-7D20KL | YAGEO | RESISTOR, CHIP, THICK FILM, SURGE CURRENT, 0402 CASE, 1/16 W, 50 V , 20K OHMS +/-5%, +/-100 PPM/DEG C, TIN TERMINATION
R111 | 1 | 5K1 | 0402 Res | RC0402JR-7D5K1L | YAGEO | RESISTOR, CHIP, THICK FILM, SURGE CURRENT, 0402 CASE, 1/16 W, 50 V , 5K1 OHMS +/-10%, +/-100 PPM/DEG C, TIN TERMINATION
R112, R113, R114, R115, R119, R414, R415, R416, R419 | 9 | NC | 0402 Res | NC | YAGEO | RESISTOR, CHIP, THICK FILM, NC | 不贴
R118, R120, R418, R706 | 4 | 0R | 0402 Res | RC0402JR-7D0RL | YAGEO | RESISTOR, CHIP, THICK FILM, SURGE CURRENT, 0402 CASE, 1/16 W, 50V, 1 A , 0 OHMS +/-5%, +/-200 PPM/DEG C, TIN TERMINATION
R125, R600, R601 | 3 | 0R | 1206 RES | RC1206FR-XX0RL | Yageo | RES, TF-SMT1206, 0 Ohm, 1% 1/4W
R213, R214, R215, R404, R420, R421 | 6 | 1K | 0402 Res | RC0402JR-7D1KL | YAGEO | RESISTOR, CHIP, THICK FILM, SURGE CURRENT, 0402 CASE, 1/16 W, 50 V , 1K OHMS +/-5%, +/-100 PPM/DEG C, TIN TERMINATION
R216, R604 | 2 | 300R | 0402 Res | RC0402JR-7D300RL | YAGEO | RESISTOR, CHIP, THICK FILM, SURGE CURRENT, 0402 CASE, 1/16 W, 50 V , 150R OHMS +/-5%, +/-100 PPM/DEG C, TIN TERMINATION
R300, R301, R302, R336, R337, R338, R339, R340, R341, R342, R343, R710 | 12 | 1M | 0402 Res | RC0402JR-7D1ML | YAGEO | RESISTOR, CHIP, THICK FILM, SURGE CURRENT, 0402 CASE, 1/16 W, 50 V , 20K OHMS +/-5%, +/-100 PPM/DEG C, TIN TERMINATION
R304, R305, R306, R307, R312, R313, R314, R315, R320, R321, R322, R323, R328, R329, R330, R331 | 16 | 120k | 1206 RES | RC1206JR-07120KL | Yageo | RES, TF-SMT1206, 120k Ohm, 1% 1/4W
R344, R510, R511 | 3 | 220 | 0805 Res | RC0805JR-7D220RL | YAGEO | RESISTOR, CHIP, THICK FILM, SURGE CURRENT, 0805 CASE, 1/8 W, 150V, 1 A , 210 OHMS +/-5%, +/-200 PPM/DEG C, TIN TERMINATION
R400, R409, R410, R413 | 4 | 2K | 0402 Res | RC0402JR-7D2KL | YAGEO | RESISTOR, CHIP, THICK FILM, SURGE CURRENT, 0402 CASE, 1/16 W, 50 V , 2K OHMS +/-5%, +/-100 PPM/DEG C, TIN TERMINATION
R402, R403, R405, R406 | 4 | 150R | 0402 Res | RC0402JR-7D150RL | YAGEO | RESISTOR, CHIP, THICK FILM, SURGE CURRENT, 0402 CASE, 1/16 W, 50 V , 150R OHMS +/-5%, +/-100 PPM/DEG C, TIN TERMINATION
R408, R411 | 2 | 15R | 0402 Res | RC0402JR-7D15KL | YAGEO | RESISTOR, CHIP, THICK FILM, SURGE CURRENT, 0402 CASE, 1/16 W, 50 V , 15K OHMS +/-5%, +/-100 PPM/DEG C, TIN TERMINATION
R417, R502, R504, R507, R509, R707, R708 | 7 | 510R | 0402 Res | RC0402JR-7D510RL | YAGEO | RES, Carbon Film SMT0402, 510 Ohm, 5%, 1/16W
R503, R508 | 2 | 120R | 0402 Res | RC0402JR-7D120RL | YAGEO | RESISTOR, CHIP, THICK FILM, SURGE CURRENT, 0402 CASE, 1/16 W, 50 V , 150R OHMS +/-5%, +/-100 PPM/DEG C, TIN TERMINATION
R709 | 1 | 12K1 | 0402 Res | RC0402FR-0712K1L | YAGEO | RESISTOR, CHIP, THICK FILM, SURGE CURRENT, 0402 CASE, 1/16 W, 50 V , 12K OHMS +/-1%, +/-100 PPM/DEG C, TIN TERMINATION
S200 | 1 | ADE-SW-Button 6X6 | Switch P4 6X6 |  |  | button 6X6,4pin, https://detail.tmall.com/item.htm?id=536551817827&rn=ee0ff7ea2e2bc9ea889df9de6a9247ba&abbucket=2
S201 | 1 | Kingsum-SW-Button 668 | SW 6X6X8
U100 | 1 | LH20-10B24 | LH25 | LH20-10B24 | MORNSUN | 85-264V，20W，24V AC/DC | 不贴
U101 | 1 | TPS54335ADDAR | SOIC-SN8_EP | TPS54335ADDAR | TI | 3A, 28V, 500kHz Synchronous Step-Down Converter
U102 | 1 | TP5410 | SOIC-SN8_EP | TP5410 | NanJing Top Power ASIC | 1A,LION,5V/1A BOOST |  | 1
U103 | 1 | RT9193-33GB | SOT23-05 | RT9193-33GB | RICHTEK | 300mA, Ultra-Low Noise, Ultra-Fast CMOS LDO Regulator |  | 0.3
U104 | 1 | Value | LC-TO-263-5 | LP38501ATJ | TI | LDO 3.8V Output 3A
U105 | 1 | Value | SOT223_M | TLV1117-33CDCYR | TI | LDO, SOT-223, 3.3V, 800mA
U106 | 1 | DMG6602SVT-7 | SOT23-06_M | DMG6602SVT-7 | DIODES | +/-30V 1.6A, -1.4A, NMOS,PMOS, 2*2 Low RON resistance |  | 0.2
U200 | 1 | STM32F207VET6 | LQFP100 | STM32F207VET6 | ST | ARM M3, 100pinLQFP, ST Semiconductor |  | 25
U201 | 1 | W25Q64JVSSIQ | SOICW-8 | W25Q64JVSSIQ | WINBOND | 3V 64MBIT SERIAL FLASH MEMORY WITH DUAL/QUAD SPI |  | 5
U202 | 1 | TF-15X15A | TF Socket SOFUNG | TF-15X15A | SOFNG | TF SOCKET |  | 0.7
U304, U500, U504 | 3 | B0505S-1W | B0505S | B0505S-1W | MORNSUN | DC/DC module 5Vin 5Vout, 1W, 1000V |  | 5
U400, U402 | 2 | OPA2340UA | SOIC-SN8_M | OPA2340UA | TI | SINGLE-SUPPLY, RAIL-TO-RAIL OPERATIONAL AMPLIFIERS
U403 | 1 | XTR111AIDGQT | LC-MSOP-EP-10 | XTR111AIDGQT | TI | Precision Voltage-to-Current Converter/Transmitter
U501, U505 | 2 | MAX202ESE | SOIC-16 | MAX202ESE | MAXIM | 5V, RS-232 Transceivers with 0.1μF External Capacitors |  | 4
U502, U506 | 2 | ADUM3201ARZ | SOIC-SN8_M | ADUM3201ARZ | RICHTEK | Dual-Channel, Digital Isolators, Enhanced System-Level ESD Reliability |  | 0.5
U503, U507 | 2 | MAX13487EESA | SOIC-SN8_M | MAX13487EESA | MAXIM | Half-Duplex RS-485-/RS-422-Compatible |  | 5
U600 | 1 | DS1138-06-06SS4BSR | SIM Socket | DS1138-06-06SS4BSR | CONNFLY | SIM SOCKET |  | 0.5
U602 | 1 | MG301 | LCC68 | MG301 | HUAWEI | GSM/GPRS MODULE | 不贴 | 30
U603 | 1 | SIM800C | SIM800C | SIM800C | HUAWEI | GSM/GPRS MODULE | 不贴 | 30
U700 | 1 | LAN8720Ai | QFN24 4X4 0.5 | LAN8720Ai | SMSC | Small Footprint RMII 10/100 Ethernet Transceiver with HP Auto-MDIX Support |  | 3.4
U701 | 1 | HR911105A | RJ45 Socket | HR911105A | HANRUN | RJ45 SOCKET |  | 3
X200 | 1 | 32.768kHz | XTAL | NX3215SA-STD-MUA-14 | NDK | Cystal Oscillator,STD-MUA-14, 32.768kHZ, SMD, 6pF |  | 0.8
X201, X700 | 2 | 25MHz | XTAL_4 - 25X20 | XXCCCLNANF-25M | TACT | Cystal Oscillator, NX2520SA , 32MHZ, SMD, 15pF |  | 1.5
 |  |  |  |  |  |  |  | 115.9
