355911097/gatewayapp/doc/新网关原理图/新网关需求/新版物联网网关需求分析(1).xlsx

Sheet: 分析报告
方案一
总板（全贴） |  | 总板（IO） | 总板（ANG）
 |  |  | 不贴控制与信号输入
 |  | 不贴模拟采集与通信
全功能板
方案二
主机 |  | 开关模块（Lora） | 传感模块（Lora）
单价/出货量（不计人工，1k 90%,5k 85%,10k 80%）
注： | 不带认证，500pcs以上方案二成本更低（但非常有限，到达10k单件成本差别10-50元）
 | 带认证，5000pcs以上方案二成本更低（到达10k，成本相差5-50元）
研发投入 | 方案一：单板开发，周期约1.5-2月，累计开发投入5月人
 | 方案二：三板或四板开发，周期约4-6月，累计开发投入10月人
 | 方案二（GPRS）：三板或四板开发，周期约4-5月，累计开发投入7-8月人
方案建议

Sheet: 方案比较
项目 | 物联网网关
 | 方案一 |  |  | 方案二*
 | 总板（全贴） | 总板（IO） | 总板（ANG） | 主机 | 开关模块（Lora） | 传感模块（Lora）
主要功能
云接入 | GPRS/Ethernet | GPRS/Ethernet | GPRS/Ethernet | GPRS/Ethernet | - | -
RS232/RS485 | 2路 | - | - | 2路 | - | -
Lora | 可扩展1路 | 可扩展1路 | 可扩展1路 | 1路 | 1路 | 1路
电源 | 220V-24V,5V | 220V-24V,5V | 220V-24V,5V | 220V-5V | 220V-5V | 220V-24V,5V
本地数据暂存（>48h） | 支持 | 支持 | 支持 | 支持 | 支持 | 支持
诊断数据存储（>7天） | 支持 | 支持 | 支持 | 支持 | 不支持 | 不支持
后备电源（10min） | 支持 | 支持 | 支持 | 支持 | 支持 | 支持
模拟输入 | 3 | - | 3 | - | - | 3
开关输入 | 7 | 7 | - | - | 7 | -
开关输出 | 4 | 4 | - | - | 4 | -
结构尺寸
长 | 200 | 200 | 200 | 130 | 130 | 100
宽 | 130 | 130 | 130 | 130 | 130 | 130
高 | 30 | 30 | 30 | 30 | 30 | 30
接口数量 | 35/1/1/2 | 16/1/1/2 | 9/1/1/2 | 10/1/1/2 | 16/1/1/2 | 9/1/1/2
接口类型 | IO/RJ45+SMA+PW | IO/RJ45+SMA+PW | IO/RJ45+SMA+PW | IO/RJ45+SMA+PW | IO/RJ45+SMA+PW | IO/RJ45+SMA+PW | 380V
成本
BOM成本 | 251.4 | 140.3 | 153.9 | 196.8 | 140.3 | 153.9
制板成本 | 20 | 20 | 20 | 13 | 13 | 10
贴片成本/测试/包装 | 75.42 | 42.09 | 46.17 | 59.04 | 42.09 | 46.17
模具成本 | 20 | 20 | 20 | 13 | 13 | 10
制板工程费+钢网 | 1500 | 0 | 0 | 1300 | 1300 | 1300
贴片工程费 | 2500 | 2500 | 2500 | 2500 | 2500 | 2500
模具工程费 | 5000 | 0 | 0 | 5000 | 5000 | 5000 | 散热评估
测试治具费 | 1000 | 0 | 0 | 1000 | 1000 | 1000
单套费用 | 366.82 | 222.39 | 240.07 | 281.84 | 208.39 | 220.07
全套工程费用 | 10000 | 2500 | 2500 | 9800 | 9800 | 9800
认证费用 | 150000 | 0 | 0 | 150000 | 150000 | 150000
开发时间(单轮)
SCH | 2-3周 | - | - | 2-3周 | 1周 | 1周
PCB | 1-2周 | - | - | 1-2周 | 1-2周 | 1-2周
模具 | 2-4周 | - | - | 2-4周 | 2-3周 | 2-3周
固件 | 3-4周 | - | - | 3-4月** | - | - | 徐军
测试治具开发 | 4周 | - | - | 3周 | 3周 | 3周
整机可靠性测试 | 4周 | - | - | 4周 | 4周 | 4周
开发时长 | 1.5-2月 |  |  | 4-6月
累计开发投入 | 5月/人 |  |  | 10月/人
* 方案二 还可以采用通信电源主板+三类接口板的叠板设计（类似目前的设计）， 尺寸约为100*80*50
** 设计到网络规划和系统设计，如果采用GPRS可以缩短为3-4周
估算单价/出货数量（套） | 不带认证
 | 总板（全贴） | 总板（IO） | 总板（ANG） | 主机 | 开关模块（Lora） | 传感模块（Lora）
10 | 1366.82 | 472.39 | 490.07 | 1261.84 | 1188.39 | 1200.07
50 | 566.82 | 272.39 | 290.07 | 477.84 | 404.39 | 416.07
100 | 466.82 | 247.39 | 265.07 | 379.84 | 306.39 | 318.07
500 | 386.82 | 227.39 | 245.07 | 301.44 | 227.99 | 239.67
1000 | 340.138 | 202.651 | 218.563 | 263.456 | 197.351 | 207.863
5000 | 313.797 | 189.5315 | 204.5595 | 241.524 | 179.0915 | 189.0195
10000 | 294.456 | 178.162 | 192.306 | 226.452 | 167.692 | 177.036
估算单价/出货数量（套） | 带认证
 | 总板（全贴） | 总板（IO） | 总板（ANG） | 主机 | 开关模块（Lora） | 传感模块（Lora）
10 | 16366.82 | 472.39 | 490.07 | 16261.84 | 16188.39 | 16200.07
50 | 3566.82 | 272.39 | 290.07 | 3477.84 | 3404.39 | 3416.07
100 | 1966.82 | 247.39 | 265.07 | 1879.84 | 1806.39 | 1818.07
500 | 686.82 | 227.39 | 245.07 | 601.44 | 527.99 | 539.67
1000 | 490.138 | 202.651 | 218.563 | 413.456 | 347.351 | 357.863
5000 | 343.797 | 189.5315 | 204.5595 | 271.524 | 209.0915 | 219.0195
10000 | 309.456 | 178.162 | 192.306 | 241.452 | 182.692 | 192.036
不计固定支出 | 总板（全贴） | 总板（IO） | 总板（ANG） | 主机 | 开关模块（Lora） | 传感模块（Lora）
10 | 3668.2 | 2223.9 | 2400.7 | 2818.4 | 2083.9 | 2200.7
50 | 18341 | 11119.5 | 12003.5 | 14092 | 10419.5 | 11003.5
100 | 36682 | 22239 | 24007 | 28184 | 20839 | 22007
500 | 183410 | 111195 | 120035 | 140920 | 104195 | 110035
1000 | 330138 | 200151 | 216063 | 253656 | 187551 | 198063
5000 | 1558985 | 945157.5 | 1020297.5 | 1197820 | 885657.5 | 935297.5
10000 | 2934560 | 1779120 | 1920560 | 2254720 | 1667120 | 1760560
1k | 0.9
5k | 0.85
10k | 0.8

Sheet: 硬件需求（总）
产品要求 | 背景需求 | 目标要求 | 其他问题 | 操作
上发服务器
GSM4频/GPRS远程通信 | 数据接入（消防主机，开关状态，传感器数据，控制，接口协议配置和固件更新） |  |  | 支持
以太网通信 | 数据接入（同上），应对GPRS无法覆盖场合 | 默认动态IP地址，可以通过电脑进行静态地址分配，可恢复出厂设置 |  | 支持
1路 232/485 | 支持消防主机协议转译（万达的案子） |  |  | 支持（由于使用场景不冲突，合并消防设备接入功能，软件配置）
Lora | 多楼宇数据汇总（区域内多主机） |  |  | 扩展支持（与分别GPRS上报成本接近）
消防设备接入
2路 232/485 | 消防主机接入（消防主机通信） | 同时支持两种设备商的接入 |  | 支持
采集控制端
AC/DC电源集成 | 一体封装，直接220V输入 | 24W（24V/1A） |  | 预备支持（考察尺寸，功率与散热）
Flash | 暂存更新固件，协议配置文件，以及短时掉网数据的保存 | 48h 数据保存（2两天的故障解决门限） | GPRS模块损坏 | 支持
TF卡 | 系统诊断（原始消息记录，诊断消息记录） |  |  | 扩展支持（保留硬件与接口电路）
后备电池 | 外部电源断电报警10分钟，功能维持8小时 |  |  | 需要确定断电维持时间与断电维持功能（明确断电场景和规范要求）
AI 3路模拟输入 | 传感器采集 | 2/3线4-20mA数据采集 |  | 支持
Lora传感器网络接入 | 传感器无线接入或控制其他节点板 |  |  | 扩展支持（系统接入数量和方式待定）
DI 7路开关输入 | 消防主机灯状态检测 | 220V电压输入，隔离 （共零线） |  | 支持（采用光耦）
DO 4路继电器输出 | 220V 2A驱动（是否共线） | 防MCU异常或死机导致系统故障 |  | 常开，常闭（以及功能）需要再确认
内部需求
复位电路 | 目前配置文件在外置Flash，烧录工具只支持内部Falsh固件更新，外部Flash需要通过云端配置，当网络配置出问题进入死锁状态。 | 增加一个复位按键，可以恢复出厂设置 |  | 支持
指示灯 | 方便在故障时候进行一些初步诊断 | 三个LED状态灯，电源，网络，工作状态 |  | 支持
蓝牙 | 方便本地配置与设置，虚拟控制面板，固件升级 |  |  | 扩展支持（保留接口）
本地数据存储功能 | 当因网络通信或其他接入故障，保存数据用于一些需要连续监测的应用场合，比如水压水位 | 初定2天数据存储（48小时故障修复） |  | 支持
诊断存储功能 | 针对一些不便人现场长期值守的偶发异常问题的诊断和排查，以及底层大数据的采集分析 | 支持TF卡 |  | 支持
后备电源 | 在网关掉电的情况下，进行现场数据保存和掉电消息上报 | 10分钟 |  | 支持（传感器功能支持需要再讨论，功耗较大且需要升压）
安装需求
连接器 | 之前拧线方式，安装维护不便 | 仍然采用工业接口确保连接可靠，但采用连接器方便施工和维护 |  | 支持

Sheet: 硬件需求（主机）
产品要求 | 背景需求 | 目标要求 | 其他问题 | 操作
上发服务器
GSM4频/GPRS远程通信 | 数据接入（消防主机，开关状态，传感器数据，控制，接口协议配置和固件更新） |  |  | 支持
以太网通信 | 数据接入（同上），应对GPRS无法覆盖场合 | 默认动态IP地址，可以通过电脑进行静态地址分配，可恢复出厂设置 |  | 支持
1路 232/485 | 支持消防主机协议转译（万达的案子） |  |  | 支持（由于使用场景不冲突，合并消防设备接入功能，软件配置）
Lora | 多楼宇数据汇总（区域内多主机） |  |  | 扩展支持（与分别GPRS上报成本接近）
消防设备接入
2路 232/485 | 消防主机接入（消防主机通信） | 同时支持两种设备商的接入 |  | 支持
采集控制端
AC/DC电源集成 | 一体封装，直接220V输入 | 5W（5V/1A） |  | 预备支持（考察尺寸，功率与散热）
Flash | 暂存更新固件，协议配置文件，以及短时掉网数据的保存 | 48h 数据保存（2两天的故障解决门限） | GPRS模块损坏 | 支持
TF卡 | 系统诊断（原始消息记录，诊断消息记录） |  |  | 扩展支持（保留硬件与接口电路）
后备电池 | 外部电源断电报警10分钟，功能维持8小时 |  |  | 需要确定断电维持时间与断电维持功能（明确断电场景和规范要求）
AI 3路模拟输入 | 传感器采集 | 2/3线4-20mA数据采集 |  | 不支持
Lora传感器网络接入 | 传感器无线接入或控制其他节点板 |  |  | 扩展支持（系统接入数量和方式待定）
DI 7路开关输入 | 消防主机灯状态检测 | 220V电压输入，隔离 （共零线） |  | 支持（采用光耦）
DO 4路继电器输出 | 220V 2A驱动（是否共线） | 防系统死机 |  | 常开，常闭（以及功能）需要再确认
内部需求
复位电路 | 目前配置文件在外置Flash，烧录工具只支持内部Falsh固件更新，外部Flash需要通过云端配置，当网络配置出问题进入死锁状态。 | 增加一个复位按键，可以恢复出厂设置 |  | 支持
指示灯 | 方便在故障时候进行一些初步诊断 | 三个LED状态灯，电源，网络，工作状态 |  | 支持
蓝牙 | 方便本地配置与设置，虚拟控制面板，固件升级 |  |  | 扩展支持（保留接口）

Sheet: 硬件需求（IO）
产品要求 | 背景需求 | 目标要求 | 其他问题 | 操作
上发服务器
GSM4频/GPRS远程通信 | 数据接入（消防主机，开关状态，传感器数据，控制，接口协议配置和固件更新） |  |  | 支持（可选）
以太网通信 | 数据接入（同上），应对GPRS无法覆盖场合 | 默认动态IP地址，可以通过电脑进行静态地址分配，可恢复出厂设置 |  | 支持（可选）
1路 232/485 | 支持消防主机协议转译（万达的案子） |  |  | 支持（由于使用场景不冲突，合并消防设备接入功能，软件配置）
Lora | 多楼宇数据汇总（区域内多主机） |  |  | 支持
消防设备接入
2路 232/485 | 消防主机接入（消防主机通信） | 同时支持两种设备商的接入 |  | 支持
采集控制端
AC/DC电源集成 | 一体封装，直接220V输入 | 5W（5V/1A） |  | 预备支持（考察尺寸，功率与散热）
Flash | 暂存更新固件，协议配置文件，以及短时掉网数据的保存 | 48h 数据保存（2两天的故障解决门限） | GPRS模块损坏 | 支持
TF卡 | 系统诊断（原始消息记录，诊断消息记录） |  |  | 扩展支持（保留硬件与接口电路）
后备电池 | 外部电源断电报警10分钟，功能维持8小时 |  |  | 需要确定断电维持时间与断电维持功能（明确断电场景和规范要求）
AI 3路模拟输入 | 传感器采集 | 2/3线4-20mA数据采集 |  | 支持
Lora传感器网络接入 | 传感器无线接入或控制其他节点板 |  |  | 扩展支持（系统接入数量和方式待定）
DI 7路开关输入 | 消防主机灯状态检测 | 220V电压输入，隔离 （共零线） |  | 支持（采用光耦）
DO 4路继电器输出 | 220V 2A驱动（是否共线） | 防系统死机 |  | 常开，常闭（以及功能）需要再确认
内部需求
复位电路 | 目前配置文件在外置Flash，烧录工具只支持内部Falsh固件更新，外部Flash需要通过云端配置，当网络配置出问题进入死锁状态。 | 增加一个复位按键，可以恢复出厂设置 |  | 支持
指示灯 | 方便在故障时候进行一些初步诊断 | 三个LED状态灯，电源，网络，工作状态 |  | 支持
蓝牙 | 方便本地配置与设置，虚拟控制面板，固件升级 |  |  | 扩展支持（保留接口）

Sheet: 硬件需求（Ang）
产品要求 | 背景需求 | 目标要求 | 其他问题 | 操作
上发服务器
GSM4频/GPRS远程通信 | 数据接入（消防主机，开关状态，传感器数据，控制，接口协议配置和固件更新） |  |  | 支持
以太网通信 | 数据接入（同上），应对GPRS无法覆盖场合 | 默认动态IP地址，可以通过电脑进行静态地址分配，可恢复出厂设置 |  | 支持
1路 232/485 | 支持消防主机协议转译（万达的案子） |  |  | 支持（由于使用场景不冲突，合并消防设备接入功能，软件配置）
Lora | 多楼宇数据汇总（区域内多主机） |  |  | 扩展支持（与分别GPRS上报成本接近）
消防设备接入
2路 232/485 | 消防主机接入（消防主机通信） | 同时支持两种设备商的接入 |  | 支持
采集控制端
AC/DC电源集成 | 一体封装，直接220V输入 | 5W（5V/1A） |  | 预备支持（考察尺寸，功率与散热）
Flash | 暂存更新固件，协议配置文件，以及短时掉网数据的保存 | 48h 数据保存（2两天的故障解决门限） | GPRS模块损坏 | 支持
TF卡 | 系统诊断（原始消息记录，诊断消息记录） |  |  | 扩展支持（保留硬件与接口电路）
后备电池 | 外部电源断电报警10分钟，功能维持8小时 |  |  | 需要确定断电维持时间与断电维持功能（明确断电场景和规范要求）
AI 3路模拟输入 | 传感器采集 | 2/3线4-20mA数据采集 |  | 支持
Lora传感器网络接入 | 传感器无线接入或控制其他节点板 |  |  | 扩展支持（系统接入数量和方式待定）
DI 7路开关输入 | 消防主机灯状态检测 | 220V电压输入，隔离 （共零线） |  | 支持（采用光耦）
DO 4路继电器输出 | 220V 2A驱动（是否共线） | 防系统死机 |  | 常开，常闭（以及功能）需要再确认
内部需求
复位电路 | 目前配置文件在外置Flash，烧录工具只支持内部Falsh固件更新，外部Flash需要通过云端配置，当网络配置出问题进入死锁状态。 | 增加一个复位按键，可以恢复出厂设置 |  | 支持
指示灯 | 方便在故障时候进行一些初步诊断 | 三个LED状态灯，电源，网络，工作状态 |  | 支持
蓝牙 | 方便本地配置与设置，虚拟控制面板，固件升级 |  |  | 扩展支持（保留接口）

Sheet: PCB尺寸和成本预估
功能模块 | 占用面积 | 说明 | 注释 | 计算 | 估算BOM价格
AC/DC | 75*55*2 | LH20-13B24 | 模块尺寸70*48，占用双面，安全隔离 | 8250 | 65
GPRS | 40*65 | MG301/SIM卡/外围 | 可以使用Mini/Micro SIM卡座 | 2600 | 42
RS232/RS485 | 50*40*2 | 双路RS232/RS485 | 目前是单路40*50*2，可以采用小封装器件 | 4000 | 43.6
模拟采集 | 50*30 | 三路4-20mA | 非隔离 | 1500 | 29.1
220V开关输入 | 50*30*2 | 7路 | 隔离，占用两面，817 | 3000 | 3.5
220V开关输出 | 50*30*2 | 4路 | 隔离，占用两面,常开，常闭,https://item.taobao.com/item.htm?id=531320463072&ns=1&abbucket=3 | 3000 | 12
以太网 | 25*25 | 1路 |  | 625 | 11
MCU | 35*35 |  | 包括晶体及其他外围电路 | 1225 | 29
电源 | 30*30 | 24-5V,5V-3V8,5V-3V3 |  | 900 | 5.8
TF卡 | 20*20 |  | TF卡座尺寸约15*15 | 400 | 0.4
连接器 | 3.5mm*10 | 300V/8A | https://item.taobao.com/item.htm?spm=a1z10.5-c.w4002-15856793348.35.270cd433vJfEwa&id=521754056197 | 1225 | 10
Lora | 40*25 |  |  | 1000 | 25
 | 估算面积 | 参考建议尺寸 |  | 估算BOM价格
总尺寸 | 25500 | 200 | 130 | 251.4
主机 | 18000 | 130 | 130 | 196.8
开关模块 | 17375 | 130 | 130 | 140.3
采集模块 | 12875 | 100 | 130 | 153.9

Sheet: GPRS_IOT_1.4
项目名称 | GPRS_IOT_1.4
序号 | 规格 | 安装位置 | 封装 | 单板用量 | 编号 |  | 价格
1.1 | 控器贴片
1.1.01 | 贴片铝电解电容[220uF/16V] | CE1，CE2，CE4，CE5，CE6 | 6.3*7.7mm | 5 | C72496
1.1.02 | 贴片电容[22uF/6.3V/0805/X5R] | C9，C13，C35，C36 | 805 | 4 | C5674
1.1.03 | 贴片电容[10uF/10V/0805/X5R] | C1，C18，C25，C32，C33，C40，C41，C49，C50 | 805 | 9 | C17024
1.1.04 | 贴片电容[2.2uF/16V/0603/X7R] | C51 | 603 | 1 | C43922
1.1.05 | 贴片电容[1uF/16V/0603/X5R] | C10，C14 | 603 | 2 | C59782
1.1.06 | 贴片电容[100nF/16V/0603/X7R] | C2，C11，C15，C17，C21，C22，C23，C24，C26，C27，C37，C38，C39，C42，C44，C52 | 603 | 16 | C66501
1.1.07 | 贴片电容[10nF/50V/0603] | C46，C47，C48 | 603 | 3 | C1589
1.1.08 | 贴片电容[2.7nF/0603] | C34 | 603 | 1 | C1609
1.1.09 | 贴片电容[330pF/0603] | C12，C16 | 603 | 2 | C1664
1.1.10 | 贴片电容[33pF/0603] | C3，C4，C5，C6 | 603 | 4 | C1663
1.1.11 | 贴片电容[22pF/0603] | C7，C8，C30，C31 | 603 | 4 | C1653
1.1.12 | 贴片电容[10pF/0603] | C28，C29 | 603 | 2 | C1634
1.1.13 | 贴片LED/绿色/0603 | D1，D5 | 603 | 2 | C72042
1.1.14 | 贴片LED/红色/0603 | D2，D4 | 603 | 2 | C72045
1.1.15 | 贴片磁珠[GZ1608D121TF] | L3，L4，L6 | 603 | 3 | C18527
1.1.16 | 贴片功率电感[4.7uH] | L5 | 5845 | 1 | C14258
1.1.17 | 贴片电阻[1M/0603/±5%] | R53 | 603 | 1 | C26098
1.1.18 | 贴片电阻[470K/0603/±1%] | R39，R40 | 603 | 2 | C23178
1.1.19 | 贴片电阻[180K/0603/±1%] | R51 | 603 | 1 | C22827
1.1.20 | 贴片电阻[100K/0603/±1%] | R2，R3，R24，R29，R54 | 603 | 5 | C25803
1.1.21 | 贴片电阻[91K/0603/±1%] | R25 | 603 | 1 | C23265
1.1.22 | 贴片电阻[47K/0603/±1%] | R9，R16，R34，R35，R36，R38 | 603 | 6 | C25819
1.1.23 | 贴片电阻[24K/0603/±1%] | R26 | 603 | 1 | C23352
1.1.24 | 贴片电阻[16K/0603/±1%] | R50 | 603 | 1 | C22818
1.1.25 | 贴片电阻[10K/0603/±1%] | R5，R6，R14，R15，R17，R19，R20，R21，R55，R62 | 603 | 10 | C25804
1.1.26 | 贴片电阻[5.6K/0603/±1%] | R58 | 603 | 1 | C23189
1.1.27 | 贴片电阻[4.7K/0603/±1%] | R10，R11，R22 | 603 | 3 | C23162
1.1.28 | 贴片电阻[3K/0603/±1%] | R8 | 603 | 1 | C4211
1.1.29 | 贴片电阻[2K/0603/±1%] | R61 | 603 | 1 | C22975
1.1.30 | 贴片电阻[1K/0603/±1%] | R23，R27，R28，R52，R59 | 603 | 5 | C21190
1.1.31 | 贴片电阻[510R/0603/±1%] | R60 | 603 | 1 | C23193
1.1.32 | 贴片电阻[470R/0603/±1%] | R1 | 603 | 1 | C23179
1.1.33 | 贴片电阻[300R/0603/±1%] | R7 | 603 | 1 | C23025
1.1.34 | 贴片自恢复保险丝1.1A | F1 | 1812 | 1 | C69691 |  | 3
1.1.35 | 贴片32.768K无源晶振[2脚] | Y1 | SMD-2*6 | 1 | 配单 | https://item.taobao.com/item.htm?spm=a230r.1.14.78.lP9SPV&id=521527550939&ns=1&abbucket=18#detail | 1
1.1.36 | 贴片25M无源晶振[4脚/3225] | Y2 | 3225 | 1 | C9006 |  | 3
1.1.37 | 贴片四脚轻触按键[ 6*6*5mm] | SW1 | KEY-6*6 SMD | 1 | C21456 |  | 0.2
1.1.38 | TF卡座 翻盖式 | J7 | TF-Card | 1 | C64205 |  | 0.4
1.1.39 | 翻盖式6脚SIM卡座 | J1 | SIM_Card | 1 | 配单 |  | 1
1.1.40 | 贴片天线座子[IPEX/IPX接头 U.FL-R-SMT] | J2 | IPEX | 1 | 配单 | https://detail.tmall.com/item.htm?id=43497770477&ali_trackid=1_e7d4de1175c1e061d4b41b17b0cd8ff4 | 7
1.1.41 | NMOS[2N7002] | Q1，Q2，Q3，Q6 | SOT-23 | 4 | C8545
1.1.42 | PMOS[AO3401A] | Q5 | SOT-23 | 1 | C15127
1.1.43 | 电压基准[TL431AIDBZR] | N1 | SOT-23 | 1 | C23892
1.1.44 | 肖特基二极管[BAT54C] | D3 | SOT-23 | 1 | C37704
1.1.45 | 肖特基二极管[BAT54A] | Q7 | SOT-23 | 1 | C8591
1.1.46 | ESD保护二极管 [PESD3V3L5UV] | U1 | SOT-666 | 1 | C7607 |  | 2
1.1.47 | 华为GSM&&GPRS模块MG301 | U2 | LCC-MG301 | 1 | 配单 |  | 30
1.1.48 | 32位处理器[STM32F205RET6] | U3 | TQFP-64 | 1 | C66278 |  | 20
1.1.49 | FLASH存储器[W25Q32JVSSIQ] | U4 | SOIC-8 | 1 | C82344 |  | 2
1.1.50 | DC-DC芯片[RT7272B] | U5 | TSOT-23-8 | 1 | 配单 |  | 1.5
1.1.51 | LDO[RT9193-33GB] | U6 | SOT23-5 | 1 | C15651 |  | 0.3
1.1.52 | CR927 3V 纽扣电池 卧式 贴片 | BT1 | 2PIN | 1 | 淘宝 | https://detail.1688.com/offer/521225211041.html?spm=b26110380.sw1688.0.0.zr7LHA | 1
 | 控器插件
1.2.01 | 2.54mm间距双排针插座2*10P | J3，J5 | HDR2X10 | 2 | C30867 |  | 5
 |  |  |  |  |  |  | 69.4
GPRS | 42
MCU | 29
电源 | 5.8

Sheet: EXT_IO_CJ_1.3
项目名称 | EXT_IO_CJ_1.3
序号 | 规格 | 安装位置 | 封装 | 单板用量 | 编号
1.1 | 控器贴片
1.1.01 | 贴片电容[100uF/50V] | C2 | 8*10.5 | 1 | C3352
1.1.02 | 贴片电容[100uF/16V] | C4 | 6.3*5.4 | 1 | C72475
1.1.03 | 贴片电容[10uF/50V/1206/X5R] | C3 | 1206 | 1 | C13585
1.1.04 | 贴片电容[10uF/10V/0805/X5R] | C5，C6，C11，C12 | 805 | 4 | C17024
1.1.05 | 贴片电容[100nF/16V/0603/X7R] | C1，C9，C10，C13 | 603 | 4 | C66501
1.1.06 | 贴片电容[10nF/50V/0603] | C8，C14，C15，C16 | 603 | 4 | C1589
1.1.07 | 贴片电容[2.7nF/0603] | C7 | 603 | 1 | C1609
1.1.08 | 贴片电阻[180K/0603/±1%] | R2 | 603 | 1 | C22827
1.1.09 | 贴片电阻[63.4K/0603/±1%] | R1 | 603 | 1 | C23093
1.1.10 | 贴片电阻[24K/0603/±1%] | R6 | 603 | 1 | C23352
1.1.11 | 贴片电阻[20K/0603/±1%] | R3，R16 | 603 | 2 | C4184
1.1.12 | 贴片电阻[11.8K/0603/±1%] | R5 | 603 | 1 | C22861
1.1.13 | 贴片电阻[10K/0603/±1%] | R4，R14 | 603 | 2 | C25804
1.1.14 | 贴片电阻[10K/0805/±0.1%] | R18，R19 | 805 | 2 | C55866
1.1.15 | 贴片电阻[4.7K/0603/±1%] | R13 | 603 | 1 | C23162
1.1.16 | 贴片电阻[2.32K/0603/±1%] | R7，R8 | 603 | 2 | C22905
1.1.17 | 贴片电阻[1K/0603/±1%] | R9，R10，R11，R12，R15 | 603 | 5 | C21190
1.1.18 | 贴片LED/绿色/0603 | D14 | 603 | 1 | C72042
1.1.19 | 贴片LED/红色/0603 | D13 | 603 | 1 | C72045
1.1.20 | 贴片功率电感/6.8uH ±20% | L1 | 5845 | 1 | C10121
1.1.21 | NMOS[2N7002] | Q1，Q2 | SOT-23 | 2 | C8545
1.1.22 | NPN三极管[S8050] | Q3 | SOT-23 | 1 | C2146
1.1.23 | 贴片四脚轻触按键[ 6*6*5mm] | SW1 | KEY-6*6 SMD | 1 | C21456
1.1.24 | 贴片自恢复保险丝500mA | F1，F2 | 1206 | 2 | C20799 |  | 0.5
1.1.25 | 贴片自恢复保险丝100mA | F3，F4 | 1206 | 2 | C20981 |  | 0.5
1.1.26 | 肖特基二极管[SS34] | D1 | SMA(DO-214AC) | 1 | C8678
1.1.27 | 肖特基二极管[SS14] | D8，D9 | SOD-123F | 2 | C59293
1.1.28 | TVS瞬态[SMAJ26CA] | D2 | SMA(DO-214AC) | 1 | C56595
1.1.29 | TVS瞬态[SMAJ7.0CA] | D10，D11 | SMA(DO-214AC) | 2 | C34043
1.1.30 | 开关二极管[1N4148] | D6 | D1206 | 1 | C9808
1.1.31 | 稳压二极管3V[MMSZ4683 3V CJ] | D7，D12 | SOD-123 | 2 | C21512 |  | 0.5
1.1.32 | DC-DC芯片[RT7272B] | U1 | SOP-8 | 1 | 配单 |  | 1.5
1.1.33 | LDO/XC6206P302MR | U2 | SOT-23 | 1 | C9972 |  | 0.1
1.1.34 | 运放OPA2340UA | U4 | SOP-8 | 1 | 配单 |  | 8
 | 控器插件
1.2.01 | 继电器/G5LA-14-5VDC | LS1 | G5LA-14-5VDC | 1 | C27822 |  | 5
1.2.02 | PCB接线端子[WJ128V-5.0-2P ] | J1，J7 | 5.0-2P | 2 | C8268 |  | 1
1.2.03 | PCB接线端子[WJ128V-5.0-4P ] | J8 | 5.0-2P | 1 | C8268 | 备注4Pin的用连个2Ppin拼接 | 1
1.2.04 | PH连接器/PH-9A/直针 | J6 | 2MM-9P | 1 | C8878 |  | 1
1.2.05 | 2.54mm间距单排针 21mm高度 10p | J2，J3 | 10P | 2 | C51353 |  | 1
1.2.06 | RJ24高精密金属膜电阻低温票125R/0.1% | R17 | RJ24 | 1 | 淘宝 | https://item.taobao.com/item.htm?spm=a230r.1.14.3.Ea6p6h&id=523167336450&ns=1&abbucket=18#detail | 0.2
 |  |  |  |  |  |  | 20.3
模拟采集 | 29.1

Sheet: ETH_IOT_1.1
项目名称 | ETH_IOT_1.1
序号 | 规格 | 安装位置 | 封装 | 单板用量 | 编号
1.1 | 控器贴片
1.1.01 | 贴片电容[10uF/10V/0805/X5R] | C5，C7，C17，C18，C21，C22，C29，C34，C41，C43，C44，C57 | 805 | 12 | C17024
1.1.02 | 贴片电容[100nF/16V/0603/X7R] | C1，C2，C3，C4，C6，C8，C9，C14，C15，C16，C19，C30，C31，C32，C33，C35，C36，C37，C42 | 603 | 19 | C66501
1.1.03 | 贴片电容[10nF/50V/0603] | C23，C24 | 603 | 2 | C1589
1.1.04 | 贴片电容[4.7nF/2KV/1206] | C40 | 1206 | 1 | C41017
1.1.05 | 贴片电容[22pF/0603] | C12，C13 | 603 | 2 | C1653
1.1.06 | 贴片电容[10pF/0603] | C10，C11，C25，C26，C27，C28 | 603 | 6 | C1634
1.1.07 | 贴片LED/绿色/0603 | D5 | 603 | 1 | C72042
1.1.08 | 贴片LED/红色/0603 | D3，D4 | 603 | 2 | C72045
1.1.09 | 贴片磁珠[GZ1608D121TF] | L1，L2，L3 | 603 | 3 | C18527
1.1.10 | 贴片电阻[1M/0603/±5%] | R44 | 603 | 1 | C26098
1.1.11 | 贴片电阻[470K/0603/±1%] | R29，R30 | 603 | 2 | C23178
1.1.12 | 贴片电阻[100K/0603/±1%] | R27，R53 | 603 | 2 | C25803
1.1.13 | 贴片电阻[47K/0603/±1%] | R5，R8，R9，R10，R11，R18 | 603 | 6 | C25819
1.1.14 | 贴片电阻[12.4K/0603/±1%] | R43 | 603 | 1 | C22865
1.1.15 | 贴片电阻[10K/0603/±1%] | R3，R4，R12，R14，R15，R16，R25，R31，R32，R42，R45，R46，R47，R48，R49 | 603 | 15 | C25804
1.1.16 | 贴片电阻[4.7K/0603/±1%] | R6，R7，R17 | 603 | 3 | C23162
1.1.17 | 贴片电阻[2.32K/0603/±1%] | R51 | 603 | 1 | C22905
1.1.18 | 贴片电阻[2K/0603/±1%] | R21 | 603 | 1 | C22975
1.1.19 | 贴片电阻[1K/0603/±1%] | R20，R22，R24，R52 | 603 | 4 | C21190
1.1.20 | 贴片电阻[510R/0603/±1%] | R19，R38，R40，R41 | 603 | 4 | C23193
1.1.21 | 贴片电阻[51R/0603/±1%] | R33，R34，R35，R36 | 603 | 4 | C23197
1.1.22 | 贴片电阻[0R/0603/±1%] | R37，R39 | 603 | 2 | C21189
1.1.23 | 贴片自恢复保险丝1.1A | F1 | 1812 | 1 | C69691 |  | 3
1.1.24 | 贴片32.768K无源晶振[2脚] | Y1 | SMD-2*6 | 1 | 配单 | https://item.taobao.com/item.htm?spm=a230r.1.14.78.lP9SPV&id=521527550939&ns=1&abbucket=18#detail | 1
1.1.25 | 贴片25M无源晶振[4脚/3225] | Y2 | 3225 | 1 | C9006 |  | 3
1.1.26 | 贴片四脚轻触按键[ 6*6*5mm] | SW1 | KEY-6*6 SMD | 1 | C21456
1.1.27 | 贴片天线座子[IPEX/IPX接头 U.FL-R-SMT] | J7 | IPEX | 1 | 配单 | https://detail.tmall.com/item.htm?id=43497770477&ali_trackid=1_e7d4de1175c1e061d4b41b17b0cd8ff4 | 0.2
1.1.28 | TF卡座 翻盖式 | J3 | TF-Card | 1 | C64205 |  | 0.4
1.1.29 | NMOS[2N7002] | Q1，Q2 | SOT-23 | 2 | C8545
1.1.30 | 电压基准[TL431AIDBZR] | U3 | SOT-23 | 1 | C23892
1.1.31 | 肖特基二极管[BAT54C] | D3 | SOT-23 | 1 | C37704
1.1.32 | 32位处理器[STM32F207VET6] | U3 | TQFP-100 | 1 | C59126 |  | 20
1.1.33 | FLASH存储器[W25Q32JVSSIQ] | U2 | SOIC-8 | 1 | C82344 |  | 2
1.1.34 | 以太网IC[LAN8720A-CP-TR] | U5 | QFN24 | 1 | C45223 |  | 3
1.1.35 | LDO[RT9193-33GB] | U4，U7 | SOT23-5 | 2 | C15651 |  | 0.5
1.1.36 | WIFI模块[WIFI_ESP-08S] | U6 | ESP-08S | 1 | 配单 | https://item.taobao.com/item.htm?spm=a230r.1.14.57.CG4CZX&id=536891267753&ns=1&abbucket=18#detail | 13
1.1.37 | CR927 3V 纽扣电池 卧式 贴片 | BT1 | 2PIN | 1 | 淘宝 | https://detail.1688.com/offer/521225211041.html?spm=b26110380.sw1688.0.0.zr7LHA | 0.6
 | 控器插件
1.2.01 | 2.54mm间距双排针插座2*10P | J1，J4 | HDR2X10 | 2 | C30867 |  | 5
1.2.02 | RJ45接口/卧式/带变压器[HR911105A] | J6 | CON12-RJ45 | 1 | C12074 |  | 5
 |  |  |  |  |  |  | 56.7
以太网 | 11

Sheet: EXT_IO_TX_1.5
项目名称 | EXT_IO_TX_1.5
序号 | 规格 | 安装位置 | 封装 | 单板用量 | 编号 | 价格
1.1 | 控器贴片
1.1.01 | 贴片电容[100uF/50V] | C5 | 8*10.2 | 1 | C3352
1.1.02 | 贴片电容[100uF/16V] | C2 | 6.3*5.4 | 1 | C72475
1.1.03 | 贴片电容[10uF/50V/1206/X5R] | C6 | 1206 | 1 | C13585
1.1.04 | 贴片电容[22uF/10V/0805/X5R] | C41，C42，C44，C45 | 805 | 4 | C29277
1.1.05 | 贴片电容[10uF/10V/0805/X5R] | C3，C4，C10，C16，C52 | 805 | 5 | C17024
1.1.06 | 贴片电容[100nF/16V/0603/X7R] | C1，C9，C12，C14，C15，C17，C18，C19，C20，C21，C32，C33，C34，C40，C43，C51，C53 | 603 | 17 | C66501
1.1.07 | 贴片电容[10nF/50V/0603] | C49，C50 | 603 | 2 | C1589
1.1.08 | 贴片电容[2.7nF/0603] | C7 | 603 | 1 | C1609
1.1.09 | 贴片LED/绿色/0603 | D5，D12 | 603 | 2 | C72042
1.1.10 | 贴片LED/红色/0603 | D4，D20 | 603 | 2 | C72045
1.1.11 | 贴片电阻[180K/0603/±1%] | R2 | 603 | 1 | C22827
1.1.12 | 贴片电阻[64.9K/0603/±1%] | R3 | 603 | 1 | C14891
1.1.13 | 贴片电阻[24K/0603/±1%] | R5 | 603 | 1 | C23352
1.1.14 | 贴片电阻[20K/0603/±1%] | R1 | 603 | 1 | C4184
1.1.15 | 贴片电阻[11.8K/0603/±1%] | R4 | 603 | 1 | C22861
1.1.16 | 贴片电阻[10K/0603/±1%] | R13，R30，R50，R51，R55，R56 | 603 | 6 | C25804
1.1.17 | 贴片电阻[5.1K/0603/±1%] | R53 | 603 | 1 | C4247
1.1.18 | 贴片电阻[4.7K/0603/±1%] | R11 | 603 | 1 | C23162
1.1.19 | 贴片电阻[3K/0603/±1%] | R14 | 603 | 1 | C4211
1.1.20 | 贴片电阻[2.32K/0603/±1%] | R7 | 603 | 1 | C22905
1.1.21 | 贴片电阻[1.5K/0603/±1%] | R6 | 603 | 1 | C22843
1.1.22 | 贴片电阻[1K/1206/±1%] | R31 | 1206 | 1 | C4410
1.1.23 | 贴片电阻[1K/0603/±1%] | R8，R9，R10，R12，R17，R18，R20，R22，R27，R29，R34，R52，R54 | 603 | 13 | C21190
1.1.24 | 贴片电阻[510R/0603/±1%] | R23，R28 | 603 | 2 | C23193
1.1.25 | 贴片电阻[240R/0805/±1%] | R15 | 805 | 1 | C17572
1.1.26 | 贴片电阻[0R/0603/±5%] | R19 | 603 | 1 | C21189
1.1.27 | 贴片功率电感/6.8uH ±20% | L1 | 5845 | 1 | C10121
1.1.28 | 贴片功率电感/4.7uH ±20% | L2 | 5845 | 1 | C14258
1.1.29 | NMOS[2N7002] | Q1，Q2 | SOT-23 | 2 | C8545
1.1.30 | 贴片四脚轻触按键[ 6*6*5mm] | SW1 | KEY-6*6 SMD | 1 | C21456
1.1.31 | 贴片自恢复保险丝500mA | F1 | 1206 | 1 | C20799 | 3
1.1.32 | 肖特基二极管[SS34] | D1，D13，D14 | SMA(DO-214AC) | 3 | C8678
1.1.33 | TVS瞬态[SMAJ26CA] | D2 | SMA(DO-214AC) | 1 | C56595
1.1.34 | TVS瞬态[SMBJ18CA] | D6，D7，D8，D9 | SMB(DO-214AA) | 4 | C8800
1.1.35 | 稳压二极管[MMSZ5242B 12V] | D3 | SOD-123 | 1 | C21567
1.1.36 | 二极管[BAT54C] | D21 | SOT-23 | 1 | C37704
1.1.37 | 二极管[BAT54A] | Q3 | SOT-23 | 1 | C8591
1.1.38 | DC-DC芯片[RT7272B] | U1 | SOP-8 | 1 | 配单 | 1.5
1.1.39 | 电池管理芯片[TP5410] | U25 | SOP-8 | 1 | C79927 | 1
1.1.40 | 贴片光耦[EL357N(C)(TA)-G] | U3 | SOP-4 | 1 | C29981 | 0.2
1.1.41 | 贴片光耦[6N137S(TA)] | U4，U6，U8 | SMD-8_6.3mm | 3 | C16496 | 0.9
1.1.42 | 接口芯片[MAX13487EESA] | U7 | SOP-8 | 1 | C18347 | 3
1.1.43 | 接口芯片[MAX202EESE+T] | U5 | SOP-16 | 1 | C9947 | 4
 | 控器插件
1.2.01 | XH2.54端子[XH-2A] | BT2 | 2.54MM-2 | 1 | C20079 | 0.2
1.2.02 | PCB接线端子[WJ128V-5.0-3P ] | J8 | 5.0-3P | 1 | C8270 | 1
1.2.03 | PCB接线端子[WJ128V-5.0-2P ] | J1，J5，J7 | 5.0-2P | 3 | C8268 | 1
1.2.04 | PH连接器/PH-9A/直针 | J6 | 2MM-9P | 1 | C8878 | 0.5
1.2.05 | 2.54mm间距单排针 21mm高度 10p | J2，J4 | 10P | 2 | C51353 | 1
1.2.06 | 直插0.12A 250V 自恢复型保险丝 | F2，F3，F4，F5 | RL250-120 | 4 | C21035 | 1
1.2.07 | 隔离电源模块/B0505S-1WR2 | U2 | SIP-4 | 1 | C18424 | 7
 |  |  |  |  |  | 25.3
RS232/RS485 | 43.6
