355911097/gatewayapp/doc/物联网网关/物料/采购申请单.xls

电气火灾采购申请
序号 | 物品名称 | 品牌 | 规格型号 | 单位 | 数量 | 单价 | 预算金额 | 备注
1 | 电气火灾监控探测器 | 安科瑞 | ARCM200L-UI | 只 | 1 | 960 | 960
2 | 剩余电流互感器 | 安科瑞 | AKH-0.66L/L-45 | 只 | 2 | 84 | 168
3 | 温度传感器 | 安科瑞 | ARCM-NTC | 只 | 2 | 30 | 60
4 | 电流互感器 | 安科瑞 | AKH-0.66L/I 30I 100/5 | 只 | 1 | 27 | 27
5 | 电气火灾监控探测器 | 安科瑞 | ARCM300-JI | 只 | 1 | 420 | 420
小计（元）： |  |  |  |  |  |  | 1635
6 | 电气火灾监控设备 | 泛海 | JB-QBL-DH500A （壁挂式，50点） | 只 | 1 | 1500 | 1500
7 | 剩余电流式电气火灾监控探测器 | 泛海 | DH-9706/200 | 只 | 1 | 228 | 228
8 | 剩余电流式电气火灾监控探测器 | 泛海 | DH-9705/260 | 只 | 1 | 348 | 348
9 | 测温式电气火灾监控探测器 | 泛海 | DH-9709 | 只 | 1 | 160 | 160
小计（元）： |  |  |  |  |  |  | 2236
金额合计（元）： |  |  |  |  |  |  | 3871
