355911097/gatewayapp/(list of files, cad)

Other CAD files:
doc/系统图 - 副本.dwg
Hw/tags/V3.20/Project/Outline.dwg
Hw/trunk/Project/Outline.dwg
Hw/tags/V2.00/Project/Outline.dwg
Hw/tags/V2.01/Project/Outline.dwg
Hw/tags/V2.10/Project/Outline.dwg
Hw/tags/V3.00/Project/Outline.dwg
Hw/tags/V3.10/Project/Outline.dwg
