355911097/gatewayapp/doc/gprs调试ip.txt

180.169.14.34:16650--->192.168.4.53:16650

180.169.14.34:16550--->192.168.4.53:16550

IMEI: 864031028233369

ATI

Manufacture: HUAWEI
Model: MG301
Revision: 11.310.21.03.00
IMEI: 864031028233369
+GCAP: +CGSM

OK
