355911097/gatewayapp/doc/物联网网关/开发调试数据.txt

登录包
3A 34 00 3A 01 00 01 00 00 00 00 00 01 00 00 00 00 00 FF FF FF FF FF FF FF FF 00 00 00 00 00 00 02 01 03 01 00 00 00 00 00 00 00 00 00 00 00 00 33 33 33 33 33 33 33 33 0D C7 16 
登录应答包
3A 1F 00 3A 01 00 02 00 00 00 00 00 01 00 00 00 00 00 FF FF FF FF FF FF FF FF 00 33 33 33 33 33 33 33 33 CD 74 16
校验错误包
3A 1F 00 3A 01 00 02 00 00 00 00 00 01 00 00 00 00 00 FF FF FF FF FF FF FF FF 00 33 33 33 33 33 33 33 33 4D 77 16

心跳包
3A 1C 00 3A 00 02 00 00 00 00 00 00 01 00 00 00 00 00 FF FF FF FF FF FF FF FF 00 01 02 03 04 05 9B CA 16

心跳应答包
3A 1C 00 3A 00 02 00 00 00 00 00 00 00 00 00 00 00 00 FF FF FF FF FF FF FF FF 00 01 02 03 04 05 A6 1B 16

重启包
3A 17 00 3A 00 03 00 00 00 00 00 00 01 00 00 00 00 00 FF FF FF FF FF FF FF FF 00 BC DE 16

重启应答包
3A 16 00 3A 00 03 00 00 00 00 00 00 01 00 00 00 00 00 FF FF FF FF FF FF FF FF 29 7D 16

火警包
3A 4B 00 3A 01 01 01 00 00 00 00 00 01 00 00 00 00 00 FF FF FF FF FF FF FF FF 00 00 00 00 11 11 11 11 22 22 22 22 33 33 33 33 01 44 44 44 44 44 44 55 55 55 55 55 55 55 55 55 55 55 55 55 55 55 55 55 55 55 55 55 55 55 55 55 55 55 55 55 55 CC 25 16
火警应答包
3A 16 00 3A 01 01 02 00 00 00 00 00 01 00 00 00 00 00 FF FF FF FF FF FF FF FF A3 B1 16
