355911097/gatewayapp/doc/新网关原理图/KS-WL-GW/KS-WL-GW-POWER.pdf

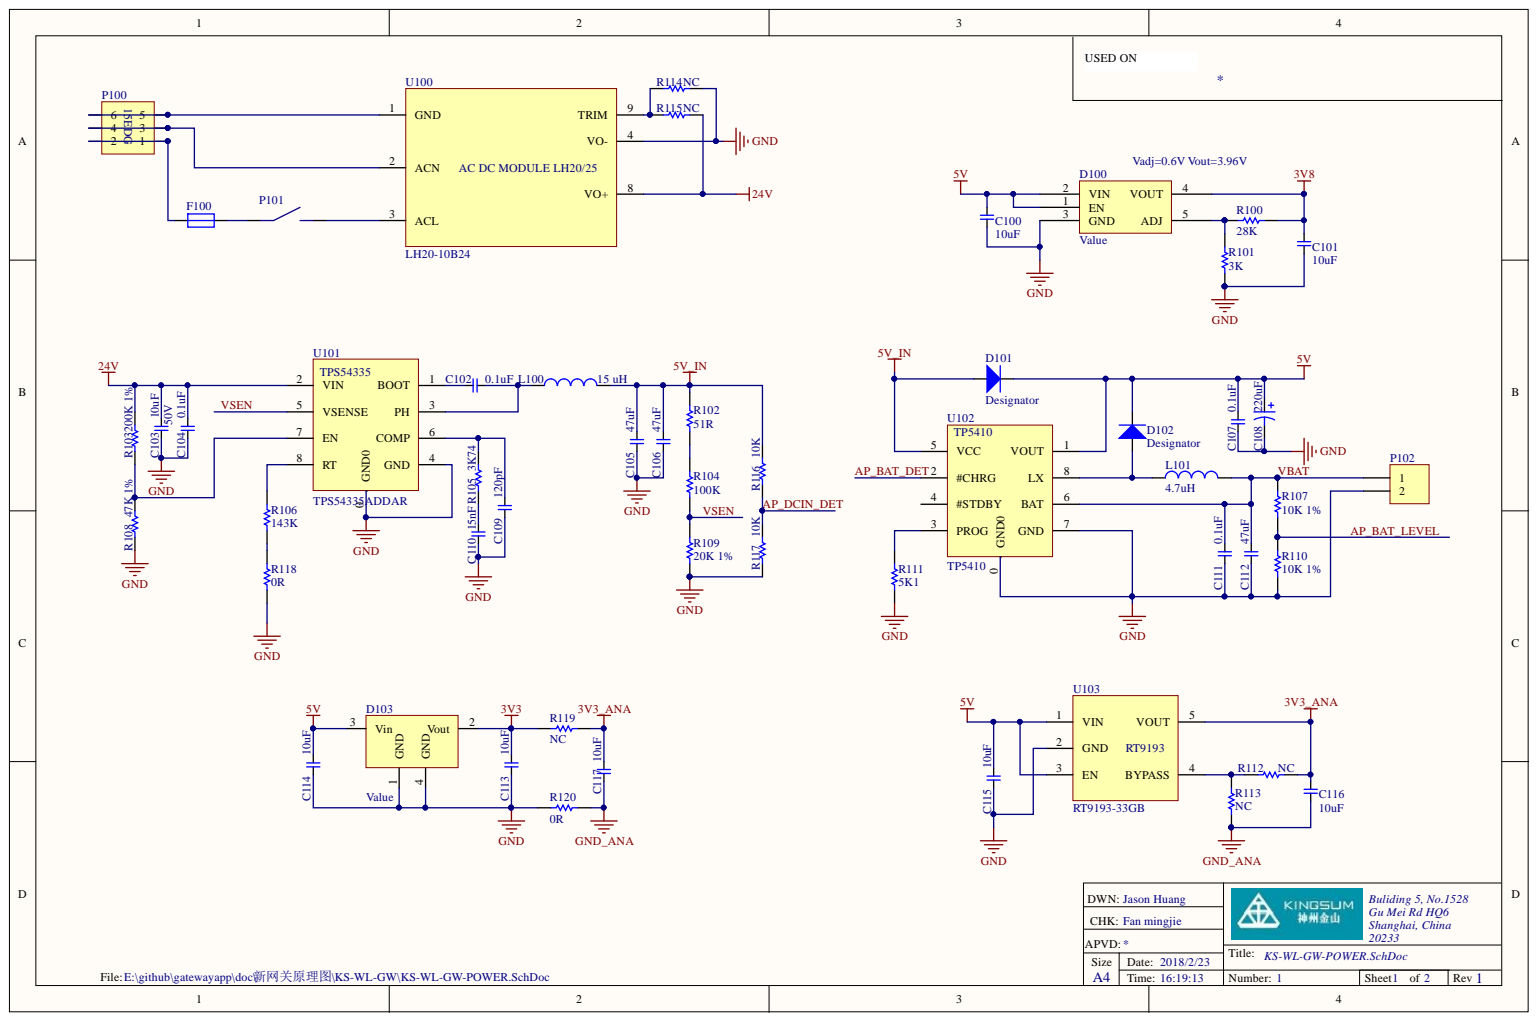
[picture p3: page 1]

Designator U102

VSEN | VSENSE 5

Date: 2018/2/23 | Title: Size

KS-WL-GW-POWER.SchDoc

File:E:\github\gatewayapp\doc\新网关原理图\KS-WL-GW\KS-WL-GW-POWER.SchDoc
