355911097/gatewayapp/doc/新网关原理图/KS-WL-GW/KS-WL-GW-RS485.pdf

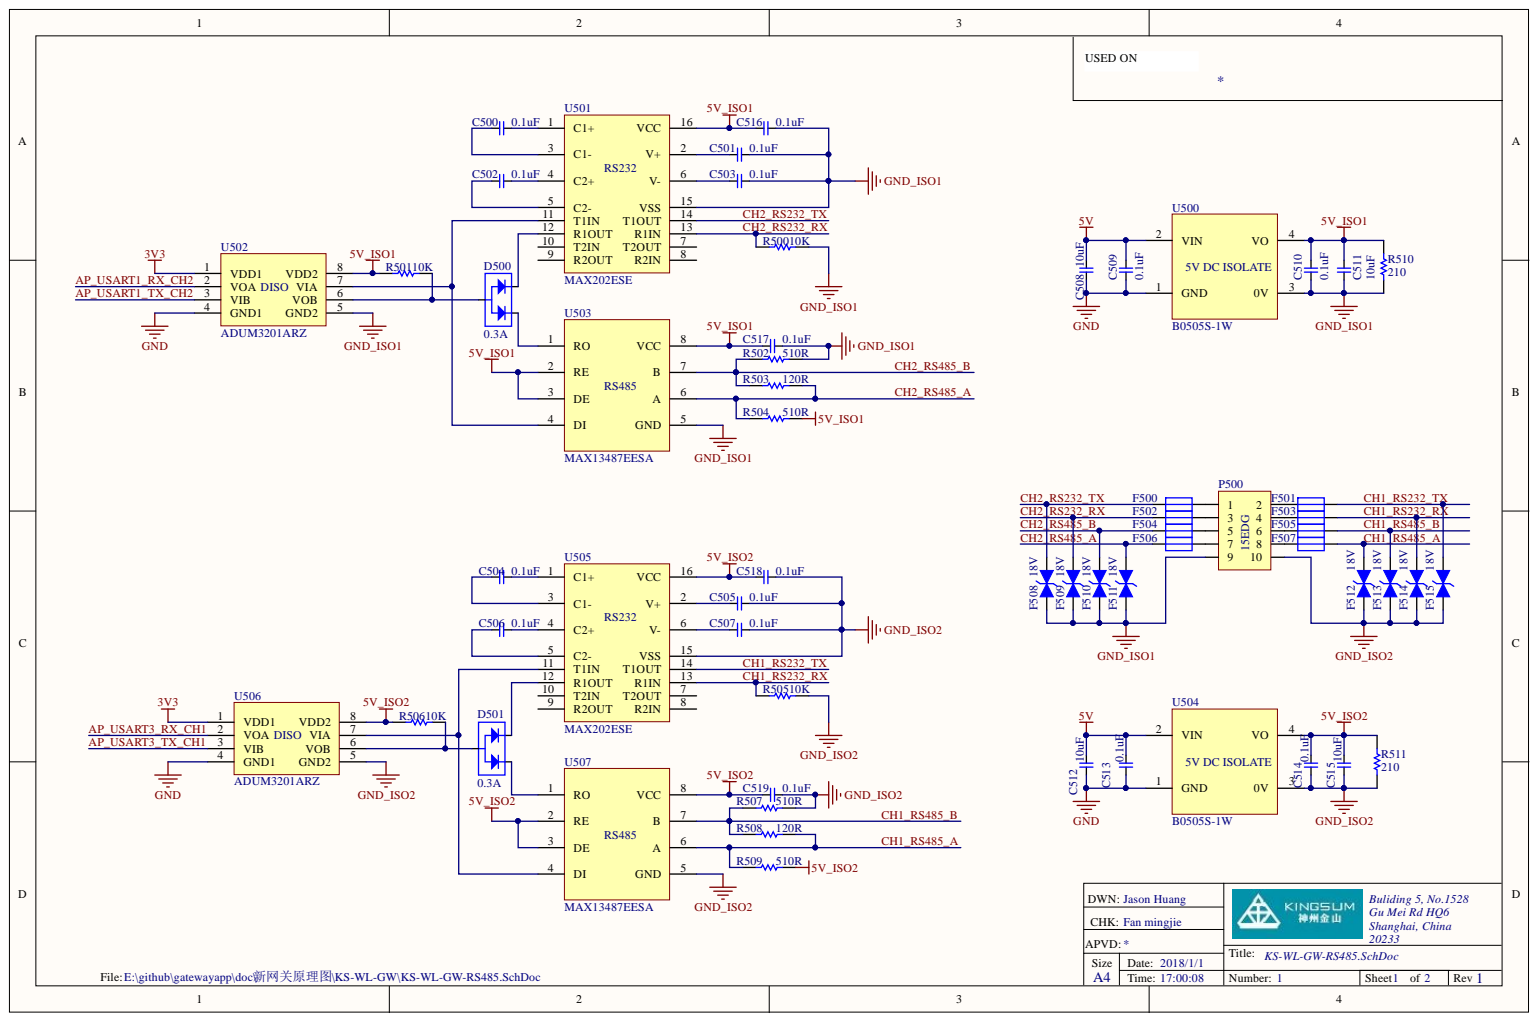
[picture p4: page 1]

R1OUT 12

GND 1

Date: 2018/1/1 | Title: Size

KS-WL-GW-RS485.SchDoc

File:E:\github\gatewayapp\doc\新网关原理图\KS-WL-GW\KS-WL-GW-RS485.SchDoc
