355911097/gatewayapp/doc/新网关原理图/KS-WL-GW/KS-WL-GW-IO.pdf

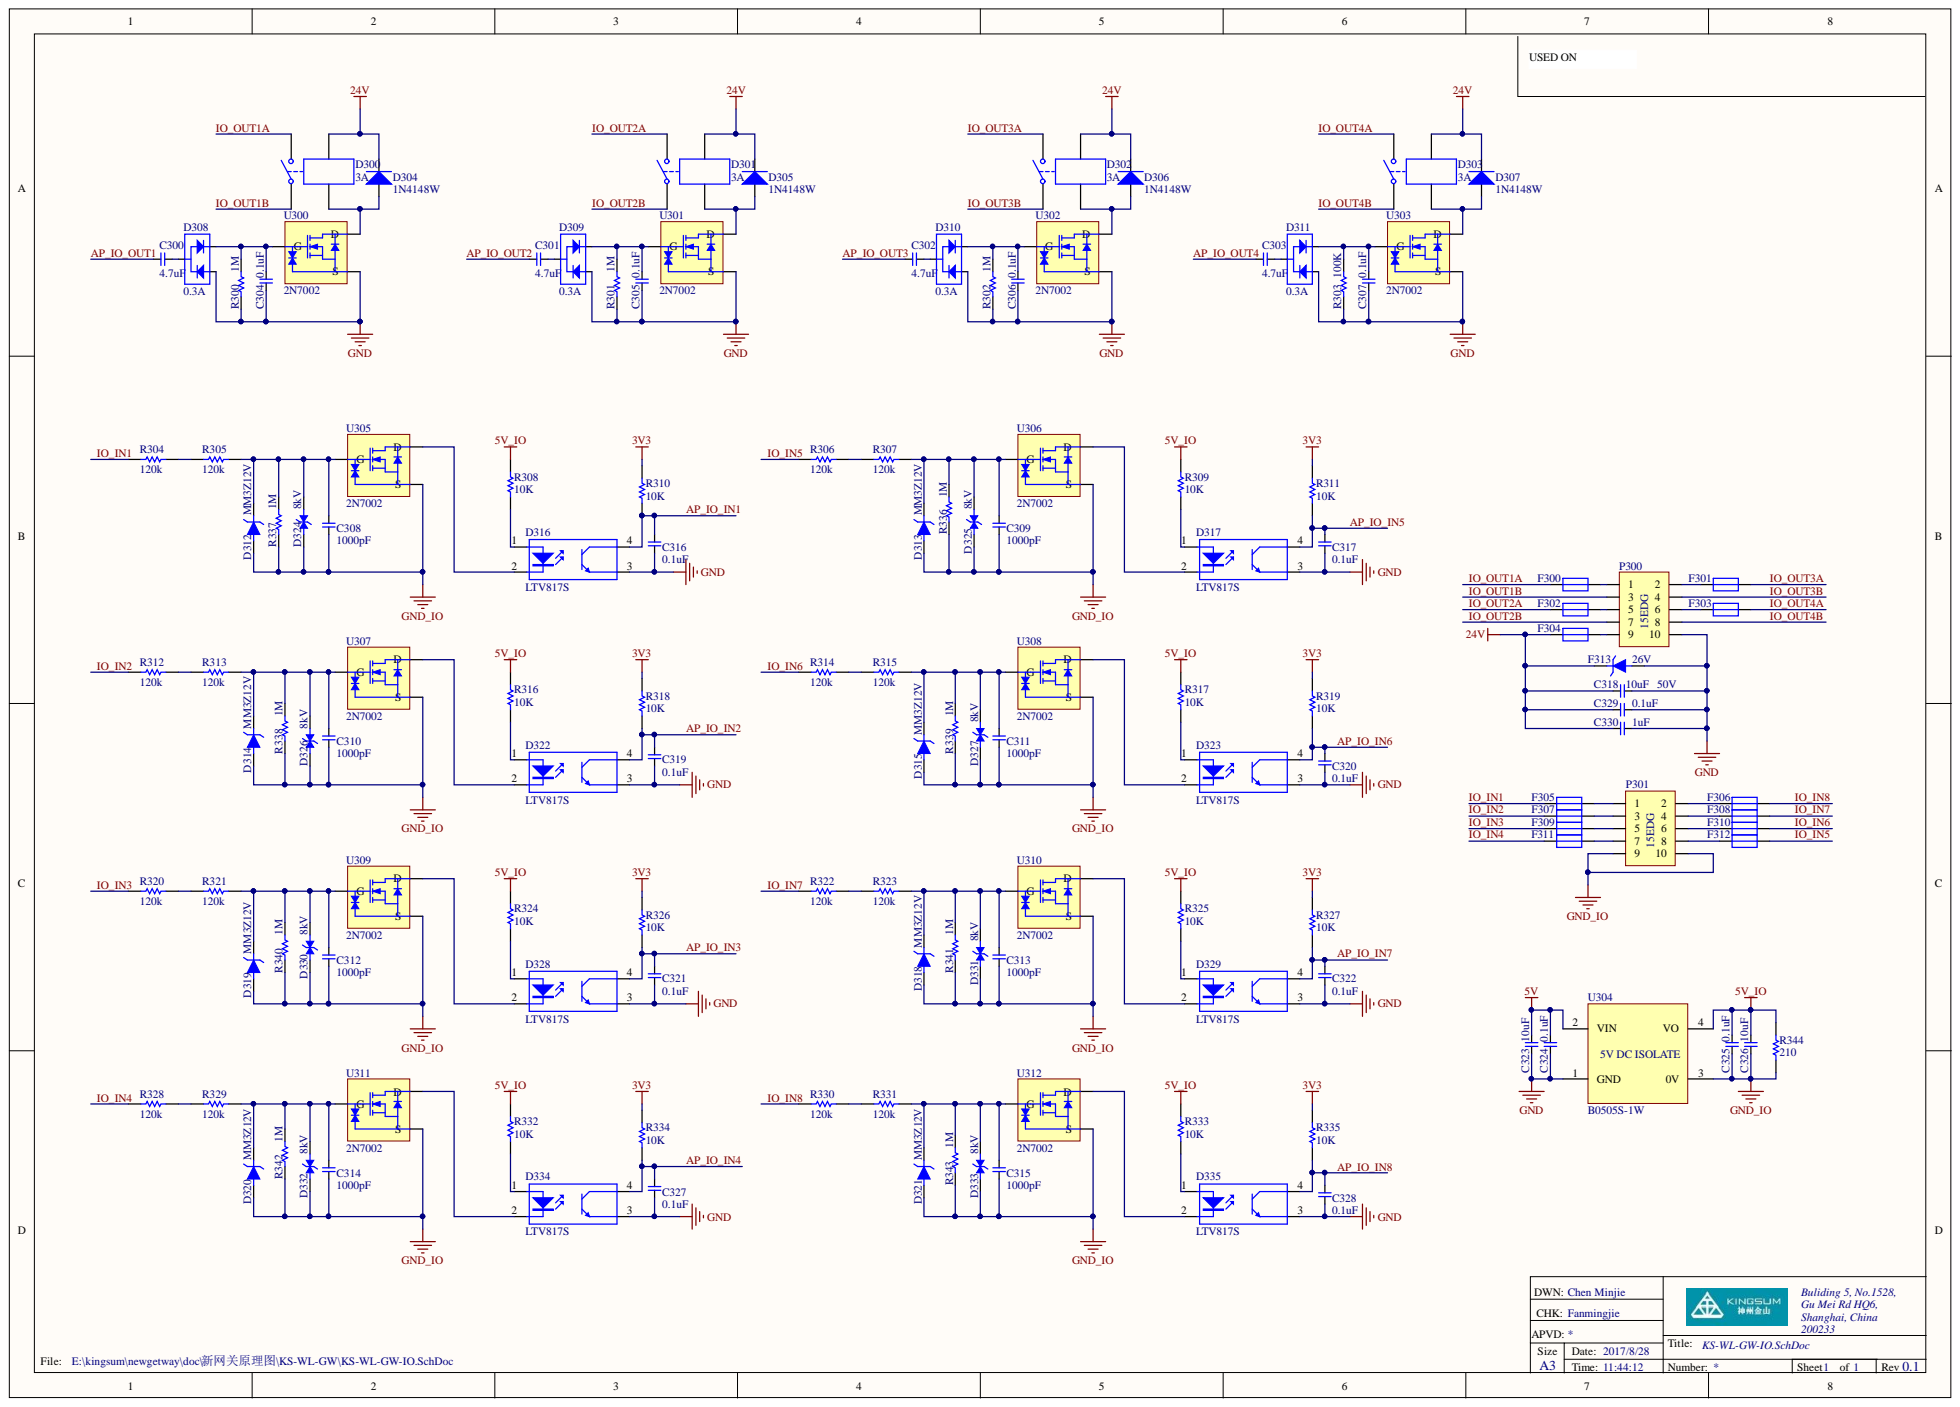
[picture p5: page 1]

11:44:12 E:\kingsum\newgetway\doc\新网关原理图\KS-WL-GW\KS-WL-GW-IO.SchDoc

2017/8/28 | Title: Size

KS-WL-GW-IO.SchDoc
