355911097/gatewayapp/(list of files, drawings)

Other design files:
doc/新网关原理图/KS-WL-GW/KS-WL-GW-ANA.SchDoc
doc/新网关原理图/KS-WL-GW/KS-WL-GW-ETH.SchDoc
doc/新网关原理图/KS-WL-GW/KS-WL-GW-GPRS.SchDoc
doc/新网关原理图/KS-WL-GW/KS-WL-GW-INTERFACE.SchDoc
doc/新网关原理图/KS-WL-GW/KS-WL-GW-IO.SchDoc
doc/新网关原理图/KS-WL-GW/KS-WL-GW-Main.SchDoc
doc/新网关原理图/KS-WL-GW/KS-WL-GW-MCU.SchDoc
doc/新网关原理图/KS-WL-GW/KS-WL-GW-POWER.SchDoc
doc/新网关原理图/KS-WL-GW/KS-WL-GW-RS485.SchDoc
Hw/tags/V1.00/Project/History/PWR_MANAGE.~(1).PRJPCB
Hw/tags/V1.00/Project/PCB_LIB/4.00mm2x10.PcbLib
Hw/tags/V1.00/Project/PCB_LIB/220VAC-12.PcbLib
Hw/tags/V1.00/Project/PCB_LIB/6002-3-0004 Rev01.PcbLib
Hw/tags/V1.00/Project/PCB_LIB/6128驱动器.PcbLib
Hw/tags/V1.00/Project/PCB_LIB/Battery1220.PCBLIB
Hw/tags/V1.00/Project/PCB_LIB/BKC.PCBLIB
Hw/tags/V1.00/Project/PCB_LIB/BTS428L2.PcbLib
Hw/tags/V1.00/Project/PCB_LIB/DYS080_V5.PcbLib
Hw/tags/V1.00/Project/PCB_LIB/LED ARRAY.PCBLIB
Hw/tags/V1.00/Project/PCB_LIB/PCB-TINYSDK2-1148.PCBLIB
Hw/tags/V1.00/Project/PCB_LIB/Putal_GPRS.PcbLib
Hw/tags/V1.00/Project/PCB_LIB/RC500Module.PcbLib
Hw/tags/V1.00/Project/PCB_LIB/RC500封装.PCBLIB
Hw/tags/V1.00/Project/PCB_LIB/RC522-HVQFN32.PcbLib
Hw/tags/V1.00/Project/PCB_LIB/Res Pack.PcbLib
Hw/tags/V1.00/Project/PCB_LIB/Rly80A.PCBLIB
Hw/tags/V1.00/Project/PCB_LIB/sk33.PCBLIB
Hw/tags/V1.00/Project/PCB_LIB/TLE6282G.PCBLIB
Hw/tags/V1.00/Project/PCB_LIB/TLP202A.PCBLIB
Hw/tags/V1.00/Project/PCB_LIB/TO263-5L.PCBLIB
Hw/tags/V1.00/Project/PCB_LIB/数码管0.4x2.PcbLib
Hw/tags/V1.00/Project/PWR_MANAGE.PRJPCB
Hw/tags/V1.00/Project/SCH_LIB/24LC02.SCHLIB
Hw/tags/V1.00/Project/SCH_LIB/78L05.SCHLIB
Hw/tags/V1.00/Project/SCH_LIB/220VAC-12.SchLib
Hw/tags/V1.00/Project/SCH_LIB/LCM0801.SchLib
Hw/tags/V1.00/Project/SCH_LIB/LCM12864.SCHLIB
Hw/tags/V1.00/Project/SCH_LIB/LM358.SCHLIB
Hw/tags/V1.00/Project/SCH_LIB/LM2576.SCHLIB
Hw/tags/V1.00/Project/SCH_LIB/LPC1752.SchLib
Hw/tags/V1.00/Project/SCH_LIB/MOC3083.SCHLIB
Hw/tags/V1.00/Project/SCH_LIB/RC522.SchLib
Hw/tags/V1.00/Project/SCH_LIB/Relay.SchLib
Hw/tags/V1.00/Project/SCH_LIB/Res Pack.SchLib
Hw/tags/V1.00/Project/SCH_LIB/STC12C5A60S2.SCHLIB
Hw/tags/V1.00/Project/SCH_LIB/TLE6282G.SCHLIB
Hw/tags/V1.00/Project/SCH_LIB/TLP202A.SCHLIB
Hw/tags/V1.00/Project/SCH_LIB/TLP627-4.SCHLIB
Hw/tags/V1.00/Project/SCHPCB/0-OverView.SCHDOC
Hw/tags/V1.00/Project/SCHPCB/1-Power.SCHDOC
Hw/tags/V1.00/Project/SCHPCB/1-PWR_CHARGE.SCHDOC
Hw/tags/V1.00/Project/SCHPCB/2-PWR_MANAGE.SchDoc
Hw/tags/V1.00/Project/SCHPCB/3-PWR_BAK_BATT.SCHDOC
Hw/tags/V1.00/Project/SCHPCB/3-PWR_MANAGE_2.SCHDOC
Hw/tags/V1.00/Project/SCHPCB/4-PWR_MANAGE_3.SCHDOC
Hw/tags/V1.00/Project/SCHPCB/5-PWR_ADC2.SCHDOC
Hw/tags/V1.00/Project/SCHPCB/5-PWR_ADC3.SCHDOC
Hw/tags/V1.00/Project/SCHPCB/5-PWR_ADC.SCHDOC
Hw/tags/V1.00/Project/SCHPCB/3043-1-1532_Rev01.PcbDoc
Hw/tags/V2.00/Project/PCB_LIB/4.00mm2x10.PcbLib
Hw/tags/V2.00/Project/PCB_LIB/220VAC-12.PcbLib
Hw/tags/V2.00/Project/PCB_LIB/6002-3-0004 Rev01.PcbLib
Hw/tags/V2.00/Project/PCB_LIB/6128驱动器.PcbLib
Hw/tags/V2.00/Project/PCB_LIB/Battery1220.PCBLIB
Hw/tags/V2.00/Project/PCB_LIB/BKC.PCBLIB
Hw/tags/V2.00/Project/PCB_LIB/BTS428L2.PcbLib
Hw/tags/V2.00/Project/PCB_LIB/DYS080_V5.PcbLib
Hw/tags/V2.00/Project/PCB_LIB/LED ARRAY.PCBLIB
Hw/tags/V2.00/Project/PCB_LIB/PCB-TINYSDK2-1148.PCBLIB
Hw/tags/V2.00/Project/PCB_LIB/Putal_GPRS.PcbLib
Hw/tags/V2.00/Project/PCB_LIB/RC500Module.PcbLib
Hw/tags/V2.00/Project/PCB_LIB/RC500封装.PCBLIB
Hw/tags/V2.00/Project/PCB_LIB/RC522-HVQFN32.PcbLib
Hw/tags/V2.00/Project/PCB_LIB/Res Pack.PcbLib
Hw/tags/V2.00/Project/PCB_LIB/Rly80A.PCBLIB
Hw/tags/V2.00/Project/PCB_LIB/sk33.PCBLIB
Hw/tags/V2.00/Project/PCB_LIB/TLE6282G.PCBLIB
Hw/tags/V2.00/Project/PCB_LIB/TLP202A.PCBLIB
Hw/tags/V2.00/Project/PCB_LIB/TO263-5L.PCBLIB
Hw/tags/V2.00/Project/PCB_LIB/数码管0.4x2.PcbLib
Hw/tags/V2.00/Project/PWR_MANAGE.PRJPCB
Hw/tags/V2.00/Project/SCH_LIB/24LC02.SCHLIB
Hw/tags/V2.00/Project/SCH_LIB/78L05.SCHLIB
Hw/tags/V2.00/Project/SCH_LIB/220VAC-12.SchLib
Hw/tags/V2.00/Project/SCH_LIB/LCM0801.SchLib
Hw/tags/V2.00/Project/SCH_LIB/LCM12864.SCHLIB
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
