355911097/gatewayapp/src/app/app.c

/*
*********************************************************************************************************
*                                              EXAMPLE CODE
*
*                          (c) Copyright 2003-2012; Micrium, Inc.; Weston, FL
*
*               All rights reserved.  Protected by international copyright laws.
*               Knowledge of the source code may NOT be used to develop a similar product.
*               Please help us continue to provide the Embedded community with the finest
*               software available.  Your honesty is greatly appreciated.
*********************************************************************************************************
*/

/*
*********************************************************************************************************
*
*                                            EXAMPLE CODE
*
*                                     ST Microelectronics STM32
*                                              on the
*
*                                           STM3220G-EVAL
*                                         Evaluation Board
*
* Filename      : app.c
* Version       : V1.00
* Programmer(s) : EHS
*                 DC
*********************************************************************************************************
*/

/*
*********************************************************************************************************
*                                             INCLUDE FILES
*********************************************************************************************************
*/
#include <string.h>
#include  <includes.h>
#include "app.h"
#include "usart.h"
#include "timer.h"
#include "gprs.h"
#include "w25qxx.h"
#include "rtc.h"
#include "ffconf.h"
#include "diskio.h"
#include "ff.h"
#include "rawudp.h"
#include "lan8720.h"
#include "lwip/dhcp.h"
#include "rawudp.h" 
#include "dhcp.h"
#include "gprs.h"
#include "protocol.h"
#include "translate.h"





extern struct netif lwip_netif;	
extern struct udp_pcb *udppcb;  	//定义一个UDP服务器控制块



extern usart_buff_t *usart3_rx_buff;
extern u8 usart3_rx_status;




/*
*********************************************************************************************************
*                                            LOCAL DEFINES
*********************************************************************************************************
*/



#define USART1_Q_NUM			1
#define USART2_Q_NUM			1
#define USART3_Q_NUM			1
#define ETH_Q_NUM				1


/*
*********************************************************************************************************
*                                       LOCAL GLOBAL VARIABLES
*********************************************************************************************************
*/ 

         /* ----------------- APPLICATION GLOBALS ------------------ */
static OS_TCB   AppTaskStartTCB;
static CPU_STK  AppTaskStartStk[APP_TASK_START_STK_SIZE];

static OS_TCB	led0_task_TCB;
static CPU_STK	led0_task_stk[LED0_TASK_STK_SIZE];

static OS_TCB	led1_task_TCB;
static CPU_STK	led1_task_stk[LED1_TASK_STK_SIZE];

OS_TCB 	gprs_init_task_TCB;
CPU_STK	gprs_init_task_stk[GPRS_INIT_TASK_STK_SIZE];


OS_TCB 	eth_init_task_TCB;
CPU_STK	eth_init_task_stk[ETH_INIT_TASK_STK_SIZE];





OS_TCB 	protocol_task_TCB;
CPU_STK	protocol_task_stk[PROTOCOL_TASK_STK_SIZE];



//OS_TCB tcpip_thread_task_TCB1;//LWIP内核任务的任务控制块
//CPU_STK tcpip_thread_task_stk1[1000];

OS_Q usart1_msg;
OS_Q usart2_msg;
OS_Q usart3_msg;
OS_Q usart4_msg;
OS_Q usart5_msg;

OS_Q eth_msg;



OS_TMR tmr1;
OS_TMR gprs;




FATFS *fatfs[FF_VOLUMES];//逻辑磁盘工作区.	 








/*
*********************************************************************************************************
*                                         FUNCTION PROTOTYPES
*********************************************************************************************************
*/
static void AppObjCreate(void);
static void AppTaskCreate(void);
static void AppTaskStart(void *p_arg);
static void led0_task_fun(void *p_arg);
static void led1_task_fun(void *p_arg);
static void usart3_task_fun(void *p_arg);
static void gprs_init_task_fun(void *p_arg);
static void eth_init_task_fun(void *p_arg);



void tmr1_callback(void *p_tmr, void *p_arg);
void gprs_callback(void *p_tmr, void *p_arg);



/*
*********************************************************************************************************
*                                                main()
*
* Description : This is the standard entry point for C code.  It is assumed that your code will call
*               main() once you have performed all necessary initialization.
*
* Arguments   : none
*
* Returns     : none
*********************************************************************************************************
*/

int main(void)
{
	struct udp_pcb *udppcb;
	u8 nn = 0;
	FRESULT res = 0;
	FATFS fs;	
	FIL fil;
	FRESULT fr;
	DIR dirs;
//	u8 work[FF_MAX_SS];
//	u8 buff[100] = {0};
	u32 bw;
	OS_ERR  err;
    CPU_SR_ALLOC();			//临界区函数使用                                        /* Init OS.                                                 */
	
	BSP_Init(); 

	
//	fs = (FATFS*)malloc(sizeof(FATFS));
//	fil = (FIL*)malloc(sizeof(FIL));
//	res = f_mkfs("", FM_ANY, 4096, work, sizeof (work));
		
//	res = f_mount(&fs, "0:", 0); 
//	if(res == 0)
//	{
//		USART_OUT(USART3, "mkfs\r");
//	}
//	
//	fr = f_mkdir("sub");
//	if(fr == 0)
//	{
//		USART_OUT(USART3, "fr1= %d\r", fr);
//	}
//	
//	fr = f_open(&fil, "123.txt", FA_CREATE_ALWAYS|FA_WRITE);
//	if(fr == 0)
//	{
//		USART_OUT(USART3, "fr1= %d\r", fr);
//	}

//	fr = f_write(&fil, "Hello, World!\r\n", 15, &bw);
//	if(fr == 0)
//	{
//		USART_OUT(USART3, "fr1= %d\r", fr);
//	}
//	f_close(&fil);

//	fr = f_open(&fil, "123.txt", FA_READ);
//	if(fr == 0)
//	{
//		USART_OUT(USART3, "fr1= %d\r", fr);
//	}
//	fr = f_read(&fil, buff, 15, &bw);
//	if(fr == 0)
//	{
//		USART_OUT(USART3, "fr1= %d\r", fr);
//	}



//    BSP_IntDisAll();                                            /* Disable all interrupts.                                  */
	
	CPU_Init();                                                 /* Initialize uC/CPU services.                              */

    OSInit(&err);  

	CPU_CRITICAL_ENTER();
	
	
	
	OSTaskCreate((OS_TCB     *)&AppTaskStartTCB,                /* Create the start task                                    */
                 (CPU_CHAR   *)"App Task Start",
                 (OS_TASK_PTR ) AppTaskStart,
                 (void       *) 0,
                 (OS_PRIO     ) APP_TASK_START_PRIO,
                 (CPU_STK    *)&AppTaskStartStk[0],
                 (CPU_STK     )(APP_TASK_START_STK_SIZE / 10u),
                 (CPU_STK_SIZE) APP_TASK_START_STK_SIZE,
                 (OS_MSG_QTY  ) 0,
                 (OS_TICK     ) 0,
                 (void       *) 0,
                 (OS_OPT      )(OS_OPT_TASK_STK_CHK | OS_OPT_TASK_STK_CLR),
                 (OS_ERR     *)&err);


	CPU_CRITICAL_EXIT();
	OSStart(&err);			//系统开始

	while (DEF_ON) {                                            /* Should Never Get Here                                    */
    };

}


/*
*********************************************************************************************************
*                                          STARTUP TASK
*
* Description : This is an example of a startup task.  As mentioned in the book's text, you MUST
*               initialize the ticker only once multitasking has started.
*
* Arguments   : p_arg   is the argument passed to 'AppTaskStart()' by 'OSTaskCreate()'.
*
* Returns     : none
*
* Notes       : 1) The first line of code is used to prevent a compiler warning because 'p_arg' is not
*                  used.  The compiler should not generate any code for this statement.
*********************************************************************************************************
*/

static void  AppTaskStart (void *p_arg)
{
    OS_ERR os_err;
	u8 nn = 0;
	CPU_SR_ALLOC();
	
	(void)p_arg;

//	BSP_Init();                                                 /* Init BSP fncts.                                          */   
    CPU_Init();                                                 /* Init CPU name & int. dis. time measuring fncts.          */
	BSP_CPU_TickInit();                                              /* Init CPU name & int. dis. time measuring fncts.          */
	
	
	
#if(OS_CFG_STAT_TASK_EN > 0)
	OSStatTaskCPUUsageInit(&os_err);	//统计任务
#endif	

#ifdef CPU_CFG_INT_DIS_MEAS_EN		//如果使能了测量中断关闭时间
    CPU_IntDisMeasMaxCurReset();	
#endif

#if	OS_CFG_SCHED_ROUND_ROBIN_EN  //当使用时间片轮转的时候
	 //使能时间片轮转调度功能,时间片长度为1个系统时钟节拍，既1*5=5ms
	OSSchedRoundRobinCfg(DEF_ENABLED,1,&os_err);  
#endif	


	CPU_CRITICAL_ENTER();
	AppObjCreate();
	
	AppTaskCreate();
	
	CPU_CRITICAL_EXIT();
				 		 
}








/*
*********************************************************************************************************
*                                          AppTaskCreate()
*
* Description : Create application tasks.
*
* Argument(s) : none
*
* Return(s)   : none
*
* Caller(s)   : AppTaskStart()
*
* Note(s)     : none.
*********************************************************************************************************
*/

static  void  AppTaskCreate (void)
{
	OS_ERR os_err;
	CPU_SR_ALLOC();
	
	
	OSTaskCreate((OS_TCB 	* )&led0_task_TCB,		
				 (CPU_CHAR	* )"led0 task", 		
                 (OS_TASK_PTR )led0_task_fun, 			
                 (void		* )0,					
                 (OS_PRIO	  )LED0_TASK_PRIO,     
                 (CPU_STK   * )&led0_task_stk[0],	
                 (CPU_STK_SIZE)LED0_TASK_STK_SIZE/10,	
                 (CPU_STK_SIZE)LED0_TASK_STK_SIZE,		
                 (OS_MSG_QTY  )0,					
                 (OS_TICK	  )0,					
                 (void   	* )0,					
                 (OS_OPT      )OS_OPT_TASK_STK_CHK|OS_OPT_TASK_STK_CLR,
                 (OS_ERR 	* )&os_err);                                             /* Create Application Kernel Objects                        */

	
	OSTaskCreate((OS_TCB 	* )&led1_task_TCB,		
				 (CPU_CHAR	* )"led1 task", 		
                 (OS_TASK_PTR )led1_task_fun, 			
                 (void		* )0,					
                 (OS_PRIO	  )LED1_TASK_PRIO,     
                 (CPU_STK   * )&led1_task_stk[0],	
                 (CPU_STK_SIZE)LED1_TASK_STK_SIZE/10,	
                 (CPU_STK_SIZE)LED1_TASK_STK_SIZE,		
                 (OS_MSG_QTY  )0,					
                 (OS_TICK	  )0,					
                 (void   	* )0,					
                 (OS_OPT      )OS_OPT_TASK_STK_CHK|OS_OPT_TASK_STK_CLR,
                 (OS_ERR 	* )&os_err);                                             /* Create Application Kernel Objects                        */
				 				                           

	OSTaskCreate((OS_TCB 	* )&eth_init_task_TCB,		
				 (CPU_CHAR	* )"eth_init_task", 		
                 (OS_TASK_PTR )eth_init_task_fun, 			
                 (void		* )0,					
                 (OS_PRIO	  )ETH_INIT_TASK_PRIO,     
                 (CPU_STK   * )&eth_init_task_stk[0],	
                 (CPU_STK_SIZE)ETH_INIT_TASK_STK_SIZE/10,	
                 (CPU_STK_SIZE)ETH_INIT_TASK_STK_SIZE,		
                 (OS_MSG_QTY  )0,					
                 (OS_TICK	  )0,					
                 (void   	* )0,					
                 (OS_OPT      )OS_OPT_TASK_STK_CHK|OS_OPT_TASK_STK_CLR,
                 (OS_ERR 	* )&os_err);                                             /* Create Application Kernel Objects                        */
	
	USART_OUT(USART3, "\eth_init_task err=%d\r", os_err);
	

				 
	usart3_task_create();			// 串口接收任务创建		 
	
	translate_task_create();		// 串口接收过来的数据转译成平台报文格式
	
	
				 
#if 0				 
	gprs_task_create();					 
#else
				 
#if LWIP_DHCP
	dhcp_task_create();				 
#endif
		 
#endif	
			 
}





/*
*********************************************************************************************************
*                                          led0_task_create()
*
* Description : Create application tasks.
*
* Argument(s) : none
*
* Return(s)   : none
*
* Caller(s)   : AppTaskStart()
*
* Note(s)     : none.
*********************************************************************************************************
*/
static void led0_task_fun(void *p_arg)
{
	OS_ERR err;

	while(DEF_TRUE)
	{
	
		if (GPIO_ReadOutputDataBit(GPIOC, GPIO_Pin_3) == 1)
		{
			GPIO_ResetBits(GPIOC, GPIO_Pin_3);
		}
		else
		{
			GPIO_SetBits(GPIOC, GPIO_Pin_3);
		//	USART_OUT(USART3, "george\r");
		}
				
		OSTimeDlyHMSM(0,0,1,0,OS_OPT_TIME_HMSM_STRICT,&err); //延时500ms
	//	OSTimeDly(1000, OS_OPT_TIME_DLY, &err);
	}
	
}
/*
*********************************************************************************************************
*                                          led0_task_create()
*
* Description : Create application tasks.
*
* Argument(s) : none
*
* Return(s)   : none
*
* Caller(s)   : AppTaskStart()
*
* Note(s)     : none.
*********************************************************************************************************
*/
static void led1_task_fun(void *p_arg)
{
	OS_ERR err;

	while(DEF_TRUE)
	{

			
		if(timer_is_timeout_1MS(tim_led1_cnt1, 1000) == 0)
		{
			if (GPIO_ReadOutputDataBit(GPIOC, GPIO_Pin_2) == 1)
			{
				GPIO_ResetBits(GPIOC, GPIO_Pin_2);
			}
			else
			{
				GPIO_SetBits(GPIOC, GPIO_Pin_2);
			//	USART_OUT(USART3, "wangzhongya\r");
			}
		}
			
		OSTimeDlyHMSM(0,0,1,0,OS_OPT_TIME_HMSM_STRICT,&err); 		//延时
//		OSTimeDly(100, OS_OPT_TIME_DLY, &err);
	}
	
}








static void eth_init_task_fun(void *p_arg)
{
	OS_ERR err;
	u8 nn[2] = {0x33, 0x42};
	u16 crc =0, crc2 = 0;
	OS_MSG_SIZE size = 0;
	u8 buff[100] = {0};
	u8 *msg = buff;
	static u8 frist_flag = 0;
	FRESULT res = 0;
	FATFS fs;	
	FIL fil;
	FRESULT fr;
	DIR dirs;
	u32 bw;
	u8 work[FF_MAX_SS];
	rtc_calendar_t ret;

	while(DEF_TRUE)
	{
		
		
			
//	res = f_mkfs("", FM_ANY, 4096, work, sizeof (work));
		
//	res = f_mount(&fs, "", 0); 
//	if(res == 0)
//	{
//		USART_OUT(USART3, "mkfs\r");
//	}
//		
//	fr = f_open(&fil, "123.txt", FA_CREATE_ALWAYS|FA_WRITE);
//	if(fr == 0)
//	{
//		USART_OUT(USART3, "fr1= %d\r", fr);
//	}

//	fr = f_write(&fil, "Hello, World!\r\n", 15, &bw);
//	if(fr == 0)
//	{
//		USART_OUT(USART3, "fr1= %d\r", fr);
//	}
//	f_close(&fil);

//	fr = f_open(&fil, "123.txt", FA_READ);
//	if(fr == 0)
//	{
//		USART_OUT(USART3, "fr1= %d\r", fr);
//	}
//	fr = f_read(&fil, buff, 15, &bw);
//	if(fr == 0)
//	{
//		USART_OUT(USART3, "fr1= %d\r", fr);
//	}

		
		
//		crc =  crc16_modbus(nn, 2);
//		USART_OUT(USART3, "fr1= %d\r", crc);
//		
//		crc2 = crc16_xmodem(nn, 2);
//		USART_OUT(USART3, "fr1= %d\r", crc2);
		OSTimeDly(1000, OS_OPT_TIME_DLY, &err);
	}

}

static void tcpip_task_fun(void *p_arg)
{
	OS_ERR err;
	u8 nn = 0;

	while(DEF_TRUE)
	{


		OSTimeDly(1000, OS_OPT_TIME_DLY, &err);
	}

}



/*
*********************************************************************************************************
*                                          AppObjCreate()
*
* Description : Create application kernel objects tasks.
*
* Argument(s) : none
*
* Return(s)   : none
*
* Caller(s)   : AppTaskStart()
*
* Note(s)     : none.
*********************************************************************************************************
*/
static  void  AppObjCreate (void)
{
	OS_ERR err;
		
	
	OSTmrCreate((OS_TMR		*)&tmr1,		//定时器1
                (CPU_CHAR	*)"tmr1",		//定时器名字
                (OS_TICK	 )500,			//500ms
                (OS_TICK	 )10000,          //1000ms
                (OS_OPT		 )OS_OPT_TMR_PERIODIC, //周期模式
                (OS_TMR_CALLBACK_PTR)tmr1_callback,//定时器1回调函数
                (void	    *)0,			//参数为0
                (OS_ERR	    *)&err);		//返回的错误码	
	
	USART_OUT(USART3, "\r err1=%d\r", err);
	OSTmrStart(&tmr1,&err);	
				
	OSTmrCreate((OS_TMR		*)&gprs,		//定时器1
                (CPU_CHAR	*)"gprs",		//定时器名字
                (OS_TICK	 )100,			//ms
                (OS_TICK	 )0,          	//ms
                (OS_OPT		 )OS_OPT_TMR_ONE_SHOT, //周期模式
                (OS_TMR_CALLBACK_PTR)gprs_callback,//定时器1回调函数
                (void	    *)0,			//参数为0
                (OS_ERR	    *)&err);		//返回的错误码	
	
	OSQCreate ((OS_Q*		)&usart1_msg,	//消息队列
                (CPU_CHAR*	)"usart1 msg",	//消息队列名称
                (OS_MSG_QTY	)USART1_Q_NUM,	//消息队列长度，这里设置为1
                (OS_ERR*	)&err);			//错误码
							
	
	OSQCreate ((OS_Q*		)&usart2_msg,	//消息队列
                (CPU_CHAR*	)"usart2 msg",	//消息队列名称
                (OS_MSG_QTY	)USART2_Q_NUM,	//消息队列长度，这里设置为1
                (OS_ERR*	)&err);			//错误码
				
	OSQCreate ((OS_Q*		)&usart3_msg,	//消息队列
                (CPU_CHAR*	)"usart3 msg",	//消息队列名称
                (OS_MSG_QTY	)USART3_Q_NUM,	//消息队列长度，这里设置为1
                (OS_ERR*	)&err);			//错误码
	
	
	OSQCreate ((OS_Q*		)&eth_msg,		//消息队列
                (CPU_CHAR*	)"eth msg",		//消息队列名称
                (OS_MSG_QTY	)ETH_Q_NUM,	//消息队列长度，这里设置为1
                (OS_ERR*	)&err);			//错误码
					
		
				
	
	
}




void tmr1_callback(void *p_tmr, void *p_arg)
{
	u8 a = 0, b = 0;
	

	
}



void gprs_callback(void *p_tmr, void *p_arg)
{

	
	
	USART_OUT(USART3, "gprs_callback\r");
//	bsp_system_reset();
}
