355911097/gatewayapp/src/bsp/bsp.c

/*
*********************************************************************************************************
*                                     MICIRUM BOARD SUPPORT PACKAGE
*
*                             (c) Copyright 2012; Micrium, Inc.; Weston, FL
*
*               All rights reserved.  Protected by international copyright laws.
*               Knowledge of the source code may NOT be used to develop a similar product.
*               Please help us continue to provide the Embedded community with the finest
*               software available.  Your honesty is greatly appreciated.
*********************************************************************************************************
*/

/*
*********************************************************************************************************
*
*                                        BOARD SUPPORT PACKAGE
*
*                                     ST Microelectronics STM32
*                                              on the
*
*                                           STM3220G-EVAL
*                                         Evaluation Board
*
* Filename      : bsp.c
* Version       : V1.00
* Programmer(s) : SL
*                 DC
*********************************************************************************************************
*/


/*
*********************************************************************************************************
*                                             INCLUDE FILES
*********************************************************************************************************
*/

#define   BSP_MODULE

#include  "bsp.h"
#include "usart.h"
#include "timer.h"
#include "gprs.h"
#include "spi.h"
#include "w25qxx.h"
#include "rtc.h"


/*
*********************************************************************************************************
*                                            LOCAL DEFINES
*********************************************************************************************************
*/


/*
*********************************************************************************************************
*                                           LOCAL CONSTANTS
*********************************************************************************************************
*/

#define LEDn                        4


/*
*********************************************************************************************************
*                                          LOCAL DATA TYPES
*********************************************************************************************************
*/


/*
*********************************************************************************************************
*                                            LOCAL TABLES
*********************************************************************************************************
*/


/*
*********************************************************************************************************
*                                       LOCAL GLOBAL VARIABLES
*********************************************************************************************************
*/







/*
*********************************************************************************************************
*                                             REGISTERS
*********************************************************************************************************
*/

#define  DWT_CR      *(CPU_REG32 *)0xE0001000
#define  DWT_CYCCNT  *(CPU_REG32 *)0xE0001004
#define  DEM_CR      *(CPU_REG32 *)0xE000EDFC


/*
*********************************************************************************************************
*                                            REGISTER BITS
*********************************************************************************************************
*/

#define  DEM_CR_TRCENA                   (1 << 24)

#define  DWT_CR_CYCCNTENA                (1 <<  0)


/*
*********************************************************************************************************
*                                      LOCAL FUNCTION PROTOTYPES
*********************************************************************************************************
*/


void bsp207_gpio_init(void);
void bsp_nvic_init(void);









void bsp_rcc_init()
{
	
	SystemInit(); 
	
	RCC_AHB1PeriphClockCmd(RCC_AHB1Periph_GPIOA | RCC_AHB1Periph_GPIOB | RCC_AHB1Periph_GPIOC, ENABLE);
	
	RCC_AHB1PeriphClockCmd(RCC_AHB1Periph_GPIOD | RCC_AHB1Periph_GPIOE | RCC_AHB1Periph_GPIOF, ENABLE);
	
	RCC_AHB1PeriphClockCmd(RCC_AHB1Periph_GPIOG | RCC_AHB1Periph_GPIOH | RCC_AHB1Periph_GPIOI, ENABLE);
	
	RCC_APB1PeriphClockCmd(RCC_APB1Periph_USART2 | RCC_APB1Periph_USART3 | RCC_APB1Periph_UART5 | RCC_APB1Periph_TIM3, ENABLE);
	
	RCC_APB1PeriphClockCmd(RCC_APB1Periph_PWR | RCC_AHB1Periph_BKPSRAM, ENABLE);//使能PWR时钟
	
	RCC_APB2PeriphClockCmd(RCC_APB2Periph_SPI1, ENABLE);
	
	RCC_APB2PeriphClockCmd(RCC_APB2Periph_SYSCFG, ENABLE);   //使能SYSCFG时钟
	//使能以太网时钟
	RCC_AHB1PeriphClockCmd(RCC_AHB1Periph_ETH_MAC | RCC_AHB1Periph_ETH_MAC_Tx | RCC_AHB1Periph_ETH_MAC_Rx, ENABLE);
	
	
	
	
}









/*
*********************************************************************************************************
*                                               BSP_Init()
*
* Description : Initialize the Board Support Package (BSP).
*
* Argument(s) : none.
*
* Return(s)   : none.
*
* Caller(s)   : Application.
*
* Note(s)     : (1) This function SHOULD be called before any other BSP function is called.
*
*               (2) CPU instruction / data tracing requires the use of the following pins :
*                   (a) (1) Aysynchronous     :  PB[3]
*                       (2) Synchronous 1-bit :  PE[3:2]
*                       (3) Synchronous 2-bit :  PE[4:2]
*                       (4) Synchronous 4-bit :  PE[6:2]
*
*                   (c) The application may wish to adjust the trace bus width depending on I/O
*                       requirements.
*********************************************************************************************************
*/

void  BSP_Init (void)
{
    /* At this stage the microcontroller clock setting is already configured,
       this is done through SystemInit() function which is called from startup
       file (startup_stm32f2xx.s) before to branch to application main.
       To reconfigure the default setting of SystemInit() function, refer to
       system_stm32f2xx.c file
     */


	bsp_rcc_init();
	bsp_nvic_init();
	bsp207_gpio_init();
	eth_gpio_init();
	usart2_init(115200);
	usart3_init(115200);
	usart5_init(115200);
	timer3_init(500-1, 120-1);
	w25qxx_init();
	rtc_init();

	
#ifdef VECT_TAB_FLASH
  NVIC_SetVectorTable(NVIC_VectTab_FLASH, 0x0);
#elif VECT_TAB_RAM
  NVIC_SetVectorTable(NVIC_VectTab_RAM,   0x0);
#endif
	
	

	
	

}


/*
*********************************************************************************************************
*                                               BSP_RNG_Read()
*
* Description : Read the value of the RNG.
*
* Argument(s) : none.
*
* Return(s)   : ????.
*
* Caller(s)   : Application.
*
* Note(s)     : none.
*********************************************************************************************************
*/

CPU_INT32U  BSP_RNG_Read (void)
{
    CPU_INT32U  rng_val;


    RCC_AHB2PeriphClockCmd(RCC_AHB2Periph_RNG, ENABLE);         /* Enable RNG clock.                                    */

    RNG->CR |= RNG_CR_IE;                                   /* Enable RNG ISR.                                      */
    RNG->CR |= RNG_CR_RNGEN;                                /* Enable LFSR & err detector.                          */

    while ((RNG->SR & RNG_SR_DRDY) == 0) {
            ;
    }
    rng_val = (CPU_INT32U)RNG->DR;                          /* Save RNG data reg.                                   */

    RNG->CR &= ~RNG_CR_IE;                                  /* Disable RNG ISR.                                     */
    RNG->CR &= ~RNG_CR_RNGEN;                               /* Disable LFSR & err detector.                         */
    RCC_AHB2PeriphClockCmd(RCC_AHB2Periph_RNG, DISABLE);        /* Disable RNG clock.                                   */

    return (rng_val);                                           /* Return rand value.                                   */
}


/*
*********************************************************************************************************
*                                            BSP_CPU_ClkFreq()
*
* Description : Read CPU registers to determine the CPU clock frequency of the chip.
*
* Argument(s) : none.
*
* Return(s)   : The CPU clock frequency, in Hz.
*
* Caller(s)   : Application.
*
* Note(s)     : none.
*********************************************************************************************************
*/

CPU_INT32U  BSP_CPU_ClkFreq (void)
{
    RCC_ClocksTypeDef  rcc_clocks;

    RCC_GetClocksFreq(&rcc_clocks);
    return ((CPU_INT32U)rcc_clocks.HCLK_Frequency);
}


/*
*********************************************************************************************************
*                                       BSP_CPU_TickInit()
*
* Description : This function reads CPU registers to determine the CPU clock frequency of the chip in KHz.
*
* Argument(s) : none.
*
* Return(s)   : none.
*
* Caller(s)   : Application.
*
* Note(s)     : none.
*********************************************************************************************************
*/

void  BSP_CPU_TickInit  (void)
{
    CPU_INT32U  cpu_clk_freq;
    CPU_INT32U  cnts;


    cpu_clk_freq = BSP_CPU_ClkFreq();                           /* Determine SysTick reference freq.                    */
#if (OS_VERSION >= 30000u)
    cnts         = (cpu_clk_freq / OSCfg_TickRate_Hz);          /* Determine nbr SysTick increments                     */
#else
    cnts         = (cpu_clk_freq / OS_TICKS_PER_SEC);
#endif
    OS_CPU_SysTickInit(cnts);                                   /* Initialize the SysTick.                            */
}



/*$PAGE*/

/*
*********************************************************************************************************
*                                          CPU_TS_TmrInit()
*
* Description : Initialize & start CPU timestamp timer.
*
* Argument(s) : none.
*
* Return(s)   : none.
*
* Caller(s)   : CPU_TS_Init().
*
*               This function is an INTERNAL CPU module function & MUST be implemented by application/
*               BSP function(s) [see Note #1] but MUST NOT be called by application function(s).
*
* Note(s)     : (1) CPU_TS_TmrInit() is an application/BSP function that MUST be defined by the developer
*                   if either of the following CPU features is enabled :
*
*                   (a) CPU timestamps
*                   (b) CPU interrupts disabled time measurements
*
*                   See 'cpu_cfg.h  CPU TIMESTAMP CONFIGURATION  Note #1'
*                     & 'cpu_cfg.h  CPU INTERRUPTS DISABLED TIME MEASUREMENT CONFIGURATION  Note #1a'.
*
*               (2) (a) Timer count values MUST be returned via word-size-configurable 'CPU_TS_TMR'
*                       data type.
*
*                       (1) If timer has more bits, truncate timer values' higher-order bits greater
*                           than the configured 'CPU_TS_TMR' timestamp timer data type word size.
*
*                       (2) Since the timer MUST NOT have less bits than the configured 'CPU_TS_TMR'
*                           timestamp timer data type word size; 'CPU_CFG_TS_TMR_SIZE' MUST be
*                           configured so that ALL bits in 'CPU_TS_TMR' data type are significant.
*
*                           In other words, if timer size is not a binary-multiple of 8-bit octets
*                           (e.g. 20-bits or even 24-bits), then the next lower, binary-multiple
*                           octet word size SHOULD be configured (e.g. to 16-bits).  However, the
*                           minimum supported word size for CPU timestamp timers is 8-bits.
*
*                       See also 'cpu_cfg.h   CPU TIMESTAMP CONFIGURATION  Note #2'
*                              & 'cpu_core.h  CPU TIMESTAMP DATA TYPES     Note #1'.
*
*                   (b) Timer SHOULD be an 'up'  counter whose values increase with each time count.
*
*                   (c) When applicable, timer period SHOULD be less than the typical measured time
*                       but MUST be less than the maximum measured time; otherwise, timer resolution
*                       inadequate to measure desired times.
*
*                   See also 'CPU_TS_TmrRd()  Note #2'.
*********************************************************************************************************
*/

#if (CPU_CFG_TS_TMR_EN == DEF_ENABLED)
void  CPU_TS_TmrInit (void)
{
    CPU_INT32U  cpu_clk_freq_hz;


    DEM_CR         |= (CPU_INT32U)DEM_CR_TRCENA;                /* Enable Cortex-M3's DWT CYCCNT reg.                   */
    DWT_CYCCNT      = (CPU_INT32U)0u;
    DWT_CR         |= (CPU_INT32U)DWT_CR_CYCCNTENA;

    cpu_clk_freq_hz = BSP_CPU_ClkFreq();
    CPU_TS_TmrFreqSet(cpu_clk_freq_hz);
}
#endif


/*$PAGE*/

/*
*********************************************************************************************************
*                                           CPU_TS_TmrRd()
*
* Description : Get current CPU timestamp timer count value.
*
* Argument(s) : none.
*
* Return(s)   : Timestamp timer count (see Notes #2a & #2b).
*
* Caller(s)   : CPU_TS_Init(),
*               CPU_TS_Get32(),
*               CPU_TS_Get64(),
*               CPU_IntDisMeasStart(),
*               CPU_IntDisMeasStop().
*
*               This function is an INTERNAL CPU module function & MUST be implemented by application/
*               BSP function(s) [see Note #1] but SHOULD NOT be called by application function(s).
*
* Note(s)     : (1) CPU_TS_TmrRd() is an application/BSP function that MUST be defined by the developer
*                   if either of the following CPU features is enabled :
*
*                   (a) CPU timestamps
*                   (b) CPU interrupts disabled time measurements
*
*                   See 'cpu_cfg.h  CPU TIMESTAMP CONFIGURATION  Note #1'
*                     & 'cpu_cfg.h  CPU INTERRUPTS DISABLED TIME MEASUREMENT CONFIGURATION  Note #1a'.
*
*               (2) (a) Timer count values MUST be returned via word-size-configurable 'CPU_TS_TMR'
*                       data type.
*
*                       (1) If timer has more bits, truncate timer values' higher-order bits greater
*                           than the configured 'CPU_TS_TMR' timestamp timer data type word size.
*
*                       (2) Since the timer MUST NOT have less bits than the configured 'CPU_TS_TMR'
*                           timestamp timer data type word size; 'CPU_CFG_TS_TMR_SIZE' MUST be
*                           configured so that ALL bits in 'CPU_TS_TMR' data type are significant.
*
*                           In other words, if timer size is not a binary-multiple of 8-bit octets
*                           (e.g. 20-bits or even 24-bits), then the next lower, binary-multiple
*                           octet word size SHOULD be configured (e.g. to 16-bits).  However, the
*                           minimum supported word size for CPU timestamp timers is 8-bits.
*
*                       See also 'cpu_cfg.h   CPU TIMESTAMP CONFIGURATION  Note #2'
*                              & 'cpu_core.h  CPU TIMESTAMP DATA TYPES     Note #1'.
*
*                   (b) Timer SHOULD be an 'up'  counter whose values increase with each time count.
*
*                       (1) If timer is a 'down' counter whose values decrease with each time count,
*                           then the returned timer value MUST be ones-complemented.
*
*                   (c) (1) When applicable, the amount of time measured by CPU timestamps is
*                           calculated by either of the following equations :
*
*                           (A) Time measured  =  Number timer counts  *  Timer period
*
*                                   where
*
*                                       Number timer counts     Number of timer counts measured
*                                       Timer period            Timer's period in some units of
*                                                                   (fractional) seconds
*                                       Time measured           Amount of time measured, in same
*                                                                   units of (fractional) seconds
*                                                                   as the Timer period
*
*                                                  Number timer counts
*                           (B) Time measured  =  ---------------------
*                                                    Timer frequency
*
*                                   where
*
*                                       Number timer counts     Number of timer counts measured
*                                       Timer frequency         Timer's frequency in some units
*                                                                   of counts per second
*                                       Time measured           Amount of time measured, in seconds
*
*                       (2) Timer period SHOULD be less than the typical measured time but MUST be less
*                           than the maximum measured time; otherwise, timer resolution inadequate to
*                           measure desired times.
*********************************************************************************************************
*/

#if (CPU_CFG_TS_TMR_EN == DEF_ENABLED)
CPU_TS_TMR  CPU_TS_TmrRd (void)
{
    return ((CPU_TS_TMR)DWT_CYCCNT);
}
#endif




/*
*********************************************************************************************************
*                                           bsp_gpio_init()
*
* Description : 初始化外I/O
*
* Argument(s) : none:
*
* Return(s)   : none.
*
* Caller(s)   : Application.
*
* Note(s)     : none.
*********************************************************************************************************
*/
void bsp205_gpio_init(void)	
{
	GPIO_InitTypeDef  gpio_init_structure;
	
	GPIO_PinAFConfig(GPIOB, GPIO_PinSource10, GPIO_AF_USART3); 
	GPIO_PinAFConfig(GPIOB, GPIO_PinSource11, GPIO_AF_USART3);
	GPIO_PinAFConfig(GPIOA, GPIO_PinSource2, GPIO_AF_USART2); 
	GPIO_PinAFConfig(GPIOA, GPIO_PinSource3, GPIO_AF_USART2);
	
	//led0
	gpio_init_structure.GPIO_Pin = GPIO_Pin_3;
	gpio_init_structure.GPIO_Mode = GPIO_Mode_OUT;
	gpio_init_structure.GPIO_OType = GPIO_OType_PP;
	gpio_init_structure.GPIO_Speed = GPIO_Speed_100MHz;
	gpio_init_structure.GPIO_PuPd = GPIO_PuPd_UP;
	GPIO_Init(GPIOC, &gpio_init_structure);
	
	//led1
	gpio_init_structure.GPIO_Pin = GPIO_Pin_2;
	gpio_init_structure.GPIO_Mode = GPIO_Mode_OUT;
	gpio_init_structure.GPIO_OType = GPIO_OType_PP;
	gpio_init_structure.GPIO_Speed = GPIO_Speed_100MHz;
	gpio_init_structure.GPIO_PuPd = GPIO_PuPd_UP;
	GPIO_Init(GPIOC, &gpio_init_structure);
	
	
	//UART2
	gpio_init_structure.GPIO_Pin = GPIO_Pin_2 | GPIO_Pin_3;	//TX RX
	gpio_init_structure.GPIO_Mode = GPIO_Mode_AF;
	gpio_init_structure.GPIO_OType = GPIO_OType_PP;
	gpio_init_structure.GPIO_Speed = GPIO_Speed_50MHz;
	gpio_init_structure.GPIO_PuPd = GPIO_PuPd_UP;
	GPIO_Init(GPIOA, &gpio_init_structure);
	
	//UART3
	gpio_init_structure.GPIO_Pin = GPIO_Pin_10 | GPIO_Pin_11;	//TX RX
	gpio_init_structure.GPIO_Mode = GPIO_Mode_AF;
	gpio_init_structure.GPIO_OType = GPIO_OType_PP;
	gpio_init_structure.GPIO_Speed = GPIO_Speed_50MHz;
	gpio_init_structure.GPIO_PuPd = GPIO_PuPd_UP;
	GPIO_Init(GPIOB, &gpio_init_structure);
	
	//SPI1
	GPIO_PinAFConfig(GPIOB,GPIO_PinSource3,GPIO_AF_SPI1); //PB3复用为 SPI1
	GPIO_PinAFConfig(GPIOB,GPIO_PinSource4,GPIO_AF_SPI1); //PB4复用为 SPI1
	GPIO_PinAFConfig(GPIOB,GPIO_PinSource5,GPIO_AF_SPI1); //PB5复用为 SPI1
	
	gpio_init_structure.GPIO_Pin = GPIO_Pin_3|GPIO_Pin_4|GPIO_Pin_5;
	gpio_init_structure.GPIO_Mode = GPIO_Mode_AF;
	gpio_init_structure.GPIO_OType = GPIO_OType_PP;
	gpio_init_structure.GPIO_Speed = GPIO_Speed_100MHz;
	gpio_init_structure.GPIO_PuPd = GPIO_PuPd_UP;
	GPIO_Init(GPIOB, &gpio_init_structure);
	
	//SPI1_NSS
	gpio_init_structure.GPIO_Pin = GPIO_Pin_15;//PA15
	gpio_init_structure.GPIO_Mode = GPIO_Mode_OUT;
	gpio_init_structure.GPIO_OType = GPIO_OType_PP;
	gpio_init_structure.GPIO_Speed = GPIO_Speed_100MHz;
	gpio_init_structure.GPIO_PuPd = GPIO_PuPd_UP;
	GPIO_Init(GPIOA, &gpio_init_structure);
	
	
	//GPRS_PWR
	gpio_init_structure.GPIO_Pin = GPIO_Pin_1;
	gpio_init_structure.GPIO_Mode = GPIO_Mode_OUT;
	gpio_init_structure.GPIO_OType = GPIO_OType_PP;
	gpio_init_structure.GPIO_Speed = GPIO_Speed_100MHz;
	gpio_init_structure.GPIO_PuPd = GPIO_PuPd_UP;
	GPIO_Init(GPIOC, &gpio_init_structure);
	
	//GPRS_ON/OFF
	gpio_init_structure.GPIO_Pin = GPIO_Pin_12;
	gpio_init_structure.GPIO_Mode = GPIO_Mode_OUT;
	gpio_init_structure.GPIO_OType = GPIO_OType_PP;
	gpio_init_structure.GPIO_Speed = GPIO_Speed_100MHz;
	gpio_init_structure.GPIO_PuPd = GPIO_PuPd_UP;
	GPIO_Init(GPIOB, &gpio_init_structure);
	
	//GPRS_RESET
	gpio_init_structure.GPIO_Pin = GPIO_Pin_7;
	gpio_init_structure.GPIO_Mode = GPIO_Mode_OUT;
	gpio_init_structure.GPIO_OType = GPIO_OType_PP;
	gpio_init_structure.GPIO_Speed = GPIO_Speed_100MHz;
	gpio_init_structure.GPIO_PuPd = GPIO_PuPd_UP;
	GPIO_Init(GPIOA, &gpio_init_structure);
		
	GPIO_ResetBits(GPIOC, GPIO_Pin_1);		// GPRS_PWR	
}




void bsp207_gpio_init(void)	
{
	GPIO_InitTypeDef  gpio_init_structure;
	
	GPIO_PinAFConfig(GPIOC, GPIO_PinSource2, GPIO_AF_UART5); 
	GPIO_PinAFConfig(GPIOD, GPIO_PinSource2, GPIO_AF_UART5);
	GPIO_PinAFConfig(GPIOD, GPIO_PinSource8, GPIO_AF_USART3); 
	GPIO_PinAFConfig(GPIOD, GPIO_PinSource9, GPIO_AF_USART3);
	
	//led0
	gpio_init_structure.GPIO_Pin = GPIO_Pin_3;
	gpio_init_structure.GPIO_Mode = GPIO_Mode_OUT;
	gpio_init_structure.GPIO_OType = GPIO_OType_PP;
	gpio_init_structure.GPIO_Speed = GPIO_Speed_100MHz;
	gpio_init_structure.GPIO_PuPd = GPIO_PuPd_UP;
	GPIO_Init(GPIOC, &gpio_init_structure);
	
	//led1
	gpio_init_structure.GPIO_Pin = GPIO_Pin_2;
	gpio_init_structure.GPIO_Mode = GPIO_Mode_OUT;
	gpio_init_structure.GPIO_OType = GPIO_OType_PP;
	gpio_init_structure.GPIO_Speed = GPIO_Speed_100MHz;
	gpio_init_structure.GPIO_PuPd = GPIO_PuPd_UP;
	GPIO_Init(GPIOC, &gpio_init_structure);
	
	
	//USART3
	gpio_init_structure.GPIO_Pin = GPIO_Pin_8 | GPIO_Pin_9;	//TX RX
	gpio_init_structure.GPIO_Mode = GPIO_Mode_AF;
	gpio_init_structure.GPIO_OType = GPIO_OType_PP;
	gpio_init_structure.GPIO_Speed = GPIO_Speed_50MHz;
	gpio_init_structure.GPIO_PuPd = GPIO_PuPd_UP;
	GPIO_Init(GPIOD, &gpio_init_structure);
	
	//UART5
	gpio_init_structure.GPIO_Pin = GPIO_Pin_2;	//TX
	gpio_init_structure.GPIO_Mode = GPIO_Mode_AF;
	gpio_init_structure.GPIO_OType = GPIO_OType_PP;
	gpio_init_structure.GPIO_Speed = GPIO_Speed_50MHz;
	gpio_init_structure.GPIO_PuPd = GPIO_PuPd_UP;
	GPIO_Init(GPIOC, &gpio_init_structure);
	
	gpio_init_structure.GPIO_Pin = GPIO_Pin_2;	//RX
	gpio_init_structure.GPIO_Mode = GPIO_Mode_AF;
	gpio_init_structure.GPIO_OType = GPIO_OType_PP;
	gpio_init_structure.GPIO_Speed = GPIO_Speed_50MHz;
	gpio_init_structure.GPIO_PuPd = GPIO_PuPd_UP;
	GPIO_Init(GPIOD, &gpio_init_structure);
	
	//SPI1
	GPIO_PinAFConfig(GPIOB,GPIO_PinSource3,GPIO_AF_SPI1); //PB3复用为 SPI1
	GPIO_PinAFConfig(GPIOB,GPIO_PinSource4,GPIO_AF_SPI1); //PB4复用为 SPI1
	GPIO_PinAFConfig(GPIOB,GPIO_PinSource5,GPIO_AF_SPI1); //PB5复用为 SPI1	
	gpio_init_structure.GPIO_Pin = GPIO_Pin_3|GPIO_Pin_4|GPIO_Pin_5;
	gpio_init_structure.GPIO_Mode = GPIO_Mode_AF;
	gpio_init_structure.GPIO_OType = GPIO_OType_PP;
	gpio_init_structure.GPIO_Speed = GPIO_Speed_100MHz;
	gpio_init_structure.GPIO_PuPd = GPIO_PuPd_UP;
	GPIO_Init(GPIOB, &gpio_init_structure);
	
	//SPI1_NSS
	gpio_init_structure.GPIO_Pin = GPIO_Pin_15;//PA15
	gpio_init_structure.GPIO_Mode = GPIO_Mode_OUT;
	gpio_init_structure.GPIO_OType = GPIO_OType_PP;
	gpio_init_structure.GPIO_Speed = GPIO_Speed_100MHz;
	gpio_init_structure.GPIO_PuPd = GPIO_PuPd_UP;
	GPIO_Init(GPIOA, &gpio_init_structure);
	
	
}

void bsp_MCO1_init(void)
{
	GPIO_InitTypeDef  gpio_init_structure;
	
	//ETH_CLK_EXT-----------------------> PA8
	//ETH_CLK_EXT
	gpio_init_structure.GPIO_Pin = GPIO_Pin_8;
	gpio_init_structure.GPIO_Mode = GPIO_Mode_AF;
	gpio_init_structure.GPIO_OType = GPIO_OType_PP;
	gpio_init_structure.GPIO_Speed = GPIO_Speed_100MHz;
	gpio_init_structure.GPIO_PuPd = GPIO_PuPd_UP;  
	GPIO_Init(GPIOA, &gpio_init_structure);
	GPIO_PinAFConfig(GPIOA, GPIO_PinSource8, GPIO_AF_MCO);
	RCC_MCO1Config(RCC_MCO1Source_HSE, RCC_MCO1Div_1);

}

void eth_gpio_init(void)
{	
	GPIO_InitTypeDef  gpio_init_structure;

	/*网络引脚设置 RMII接口 
	  ETH_MDIO -------------------------> PA2
	  ETH_MDC --------------------------> PC1
	  ETH_RMII_REF_CLK------------------> PA1
	  ETH_RMII_CRS_DV ------------------> PA7
	  ETH_RMII_RXD0 --------------------> PC4
	  ETH_RMII_RXD1 --------------------> PC5
	  ETH_RMII_TX_EN -------------------> PB11
	  ETH_RMII_TXD0 --------------------> PB12
	  ETH_RMII_TXD1 --------------------> PB13
	  ETH_RESET-------------------------> PD13
	*/

	
	bsp_MCO1_init();
	
	//ETH_RST
	gpio_init_structure.GPIO_Pin = GPIO_Pin_13;
	gpio_init_structure.GPIO_Mode = GPIO_Mode_OUT;
	gpio_init_structure.GPIO_OType = GPIO_OType_PP;
	gpio_init_structure.GPIO_Speed = GPIO_Speed_100MHz;
	gpio_init_structure.GPIO_PuPd = GPIO_PuPd_NOPULL;  
	GPIO_Init(GPIOD, &gpio_init_structure);

	
	// Configure PA1, PA2 and PA7 
	gpio_init_structure.GPIO_Pin = GPIO_Pin_1 | GPIO_Pin_2 | GPIO_Pin_7;
	gpio_init_structure.GPIO_Speed = GPIO_Speed_100MHz;
	gpio_init_structure.GPIO_Mode = GPIO_Mode_AF;
	gpio_init_structure.GPIO_OType = GPIO_OType_PP;
	gpio_init_structure.GPIO_PuPd = GPIO_PuPd_NOPULL ; 
	GPIO_Init(GPIOA, &gpio_init_structure);
	GPIO_PinAFConfig(GPIOA, GPIO_PinSource1, GPIO_AF_ETH); //引脚复用到网络接口上
	GPIO_PinAFConfig(GPIOA, GPIO_PinSource2, GPIO_AF_ETH);
	GPIO_PinAFConfig(GPIOA, GPIO_PinSource7, GPIO_AF_ETH);

	 // Configure PB12 and PB13 PB11
	gpio_init_structure.GPIO_Pin = GPIO_Pin_11 | GPIO_Pin_12 | GPIO_Pin_13;
	GPIO_Init(GPIOB, &gpio_init_structure);
	GPIO_PinAFConfig(GPIOB, GPIO_PinSource11, GPIO_AF_ETH);
	GPIO_PinAFConfig(GPIOB, GPIO_PinSource12, GPIO_AF_ETH);	
	GPIO_PinAFConfig(GPIOB, GPIO_PinSource13, GPIO_AF_ETH);
	

	 // Configure PC1 and PC4 PC5
	gpio_init_structure.GPIO_Pin = GPIO_Pin_1 | GPIO_Pin_4 | GPIO_Pin_5;
	GPIO_Init(GPIOC, &gpio_init_structure);
	GPIO_PinAFConfig(GPIOC, GPIO_PinSource1, GPIO_AF_ETH);	
	GPIO_PinAFConfig(GPIOC, GPIO_PinSource4, GPIO_AF_ETH);
	GPIO_PinAFConfig(GPIOC, GPIO_PinSource5, GPIO_AF_ETH);
	
	
}





void bsp_nvic_init(void)
{
	NVIC_InitTypeDef nvic_init_structure;
	
	
	NVIC_PriorityGroupConfig(NVIC_PriorityGroup_0);
	
	
	//USART2
	nvic_init_structure.NVIC_IRQChannel = USART2_IRQn;
    nvic_init_structure.NVIC_IRQChannelPreemptionPriority = 1;
    nvic_init_structure.NVIC_IRQChannelSubPriority = 0;
    nvic_init_structure.NVIC_IRQChannelCmd = ENABLE;	 
	NVIC_Init(&nvic_init_structure);
	
	//USART3
	nvic_init_structure.NVIC_IRQChannel = USART3_IRQn;
    nvic_init_structure.NVIC_IRQChannelPreemptionPriority = 1;
    nvic_init_structure.NVIC_IRQChannelSubPriority = 1;
    nvic_init_structure.NVIC_IRQChannelCmd = ENABLE;	 
	NVIC_Init(&nvic_init_structure);
	
	//USART5
	nvic_init_structure.NVIC_IRQChannel = UART5_IRQn;
    nvic_init_structure.NVIC_IRQChannelPreemptionPriority = 1;
    nvic_init_structure.NVIC_IRQChannelSubPriority = 2;
    nvic_init_structure.NVIC_IRQChannelCmd = ENABLE;	 
	NVIC_Init(&nvic_init_structure);
	
	//timer3
	nvic_init_structure.NVIC_IRQChannel = TIM3_IRQn;
    nvic_init_structure.NVIC_IRQChannelPreemptionPriority = 0;    //
    nvic_init_structure.NVIC_IRQChannelSubPriority = 2;
    nvic_init_structure.NVIC_IRQChannelCmd = ENABLE;
    NVIC_Init(&nvic_init_structure);
	
	//RTC_STAMP
	nvic_init_structure.NVIC_IRQChannel = TAMP_STAMP_IRQn;
    nvic_init_structure.NVIC_IRQChannelPreemptionPriority = 0;    //
    nvic_init_structure.NVIC_IRQChannelSubPriority = 3;
    nvic_init_structure.NVIC_IRQChannelCmd = ENABLE;
    NVIC_Init(&nvic_init_structure);
	
	
	//ETH
	nvic_init_structure.NVIC_IRQChannel = ETH_IRQn;
    nvic_init_structure.NVIC_IRQChannelPreemptionPriority = 0;    //
    nvic_init_structure.NVIC_IRQChannelSubPriority = 1;
    nvic_init_structure.NVIC_IRQChannelCmd = ENABLE;
    NVIC_Init(&nvic_init_structure);
	
	
}


void bsp_system_reset(void)
{
	__set_FAULTMASK(1);		//关闭总中断
	NVIC_SystemReset();
}

void bsp_iwatchdog_config(void)
{

}


void bsp_iwatchdog_clear(void)
{
	IWDG_ReloadCounter();
}
