355911097/gatewayapp/src/bsp/bsp_ser.c

/*
*********************************************************************************************************
*                                     MICRIUM BOARD SUPPORT SUPPORT
*
*                          (c) Copyright 2003-2012; Micrium, Inc.; Weston, FL
*
*               All rights reserved.  Protected by international copyright laws.
*               Knowledge of the source code may NOT be used to develop a similar product.
*               Please help us continue to provide the Embedded community with the finest
*               software available.  Your honesty is greatly appreciated.
*********************************************************************************************************
*/

/*
*********************************************************************************************************
*
*                                    MICRIUM BOARD SUPPORT PACKAGE
*                                       SERIAL (UART) INTERFACE
*
*                                     ST Microelectronics STM32
*                                              on the
*
*                                           STM3220G-EVAL
*                                         Evaluation Board
*
* Filename      : bsp_ser.c
* Version       : V1.00
* Programmer(s) : SL
*********************************************************************************************************
*/


/*
*********************************************************************************************************
*                                             INCLUDE FILES
*********************************************************************************************************
*/

#define  BSP_SER_MODULE
#include <bsp.h>
#include <bsp_ser.h>

/*
*********************************************************************************************************
*                                            LOCAL DEFINES
*********************************************************************************************************
*/

#define  BSP_SER_PRINTF_STR_BUF_SIZE             80u


/*
*********************************************************************************************************
*                                           LOCAL CONSTANTS
*********************************************************************************************************
*/


/*
*********************************************************************************************************
*                                          LOCAL DATA TYPES
*********************************************************************************************************
*/


/*
*********************************************************************************************************
*                                            LOCAL TABLES
*********************************************************************************************************
*/


/*
*********************************************************************************************************
*                                       LOCAL GLOBAL VARIABLES
*********************************************************************************************************
*/

static  BSP_OS_SEM   BSP_SerTxWait;
static  BSP_OS_SEM   BSP_SerRxWait;
static  BSP_OS_SEM   BSP_SerLock;
static  CPU_INT08U   BSP_SerRxData;


/*
*********************************************************************************************************
*                                      LOCAL FUNCTION PROTOTYPES
*********************************************************************************************************
*/

static  void        BSP_Ser_WrByteUnlocked  (CPU_INT08U  c);
static  CPU_INT08U  BSP_Ser_RdByteUnlocked  (void);
static  void        BSP_Ser_ISR_Handler     (void);


/*
*********************************************************************************************************
*                                     LOCAL CONFIGURATION ERRORS
*********************************************************************************************************
*/


/*
*********************************************************************************************************
*********************************************************************************************************
**                                         GLOBAL FUNCTIONS
*********************************************************************************************************
*********************************************************************************************************
*/


/*
*********************************************************************************************************
*                                          BSP_Ser_Init()
*
* Description : Initialize a serial port for communication.
*
* Argument(s) : baud_rate           The desire RS232 baud rate.
*
* Return(s)   : none.
*
* Caller(s)   : Application
*
* Note(s)     : none.
*********************************************************************************************************
*/

void  BSP_Ser_Init (CPU_INT32U  baud_rate)
{
    GPIO_InitTypeDef        GPIO_InitStructure;
    USART_InitTypeDef       USART_InitStructure;
    USART_ClockInitTypeDef  USART_CLK_InitStructure;


                                                                /* ------------------ INIT OS OBJECTS ----------------- */
    BSP_OS_SemCreate(&BSP_SerTxWait,   0, "Serial Tx Wait");
    BSP_OS_SemCreate(&BSP_SerRxWait,   0, "Serial Rx Wait");
    BSP_OS_SemCreate(&BSP_SerLock,     1, "Serial Lock");

                                                                /* ----------------- INIT USART STRUCT ---------------- */
    USART_InitStructure.USART_BaudRate            = baud_rate;
    USART_InitStructure.USART_WordLength          = USART_WordLength_8b;
    USART_InitStructure.USART_StopBits            = USART_StopBits_1;
    USART_InitStructure.USART_Parity              = USART_Parity_No ;
    USART_InitStructure.USART_HardwareFlowControl = USART_HardwareFlowControl_None;
    USART_InitStructure.USART_Mode                = USART_Mode_Rx | USART_Mode_Tx;

    USART_CLK_InitStructure.USART_Clock           = USART_Clock_Disable;
    USART_CLK_InitStructure.USART_CPOL            = USART_CPOL_Low;
    USART_CLK_InitStructure.USART_CPHA            = USART_CPHA_2Edge;
    USART_CLK_InitStructure.USART_LastBit         = USART_LastBit_Disable;


    RCC_AHB1PeriphClockCmd(RCC_AHB1Periph_GPIOC, ENABLE);       /* Enable GPIO clock.                                   */
    RCC_APB1PeriphClockCmd(RCC_APB1Periph_USART3, ENABLE);      /* Enable UART clock.                                   */


                                                                /* ----------------- SETUP USART3 GPIO ---------------- */
                                                                /* Configure GPIOC.5 as push-pull.                      */
    GPIO_InitStructure.GPIO_Pin   = GPIO_Pin_10;
    GPIO_InitStructure.GPIO_Speed = GPIO_Speed_50MHz;
    GPIO_InitStructure.GPIO_Mode  = GPIO_Mode_AF;
    GPIO_InitStructure.GPIO_OType = GPIO_OType_PP;
    GPIO_InitStructure.GPIO_PuPd  = GPIO_PuPd_UP;
    GPIO_Init(GPIOC, &GPIO_InitStructure);
    GPIO_PinAFConfig(GPIOC, GPIO_PinSource10, GPIO_AF_USART3);

                                                                /* Configure GPIOD.6 as input floating.                 */
    GPIO_InitStructure.GPIO_Pin   = GPIO_Pin_11;
    GPIO_InitStructure.GPIO_Mode  = GPIO_Mode_AF;
    GPIO_Init(GPIOC, &GPIO_InitStructure);
    GPIO_PinAFConfig(GPIOC, GPIO_PinSource11, GPIO_AF_USART3);

                                                                /* ------------------ SETUP USART3 -------------------- */
    USART_Init(USART3, &USART_InitStructure);
    USART_ClockInit(USART3, &USART_CLK_InitStructure);
    USART_Cmd(USART3, ENABLE);

    BSP_IntVectSet(BSP_INT_ID_USART3, BSP_Ser_ISR_Handler);
    BSP_IntEn(BSP_INT_ID_USART3);
}


/*
*********************************************************************************************************
*                                         BSP_Ser_ISR_Handler()
*
* Description : Serial ISR
*
* Argument(s) : none
*
* Return(s)   : none.
*
* Caller(s)   : This is an ISR.
*
* Note(s)     : none.
*********************************************************************************************************
*/

void  BSP_Ser_ISR_Handler (void)
{
    CPU_REG32  status;


    status = USART3->SR;

    if (DEF_BIT_IS_SET(status, DEF_BIT_05)) {
        BSP_SerRxData = USART_ReceiveData(USART3) & 0xFF;       /* Read one byte from the receive data register.      */
        USART_ClearITPendingBit(USART3, USART_IT_RXNE);         /* Clear the USART3 receive interrupt.                */
        BSP_OS_SemPost(&BSP_SerRxWait);                         /* Post to the sempahore                              */
    }

    if (DEF_BIT_IS_SET(status, DEF_BIT_07)) {
        USART_ITConfig(USART3, USART_IT_TXE, DISABLE);
        USART_ClearITPendingBit(USART3, USART_IT_TXE);          /* Clear the USART3 receive interrupt.                */
        BSP_OS_SemPost(&BSP_SerTxWait);                         /* Post to the semaphore                              */
    }
}


/*
*********************************************************************************************************
*                                                BSP_Ser_Printf()
*
* Description : Formatted outout to the serial port.
*               This funcion reads a string from a serial port. This call blocks until a
*               character appears at the port and the last character is a Carriage
*               Return (0x0D).
*
* Argument(s) : Format string follwing the C format convention.
*
* Return(s)   : none.
*
* Caller(s)   : Application
*
* Note(s)     : none.
*********************************************************************************************************
*/

void  BSP_Ser_Printf (CPU_CHAR *format, ...)
{
    CPU_CHAR  buf_str[BSP_SER_PRINTF_STR_BUF_SIZE + 1u];
    va_list   v_args;


    va_start(v_args, format);
   (void)vsnprintf((char       *)&buf_str[0],
                   (CPU_SIZE_T  ) sizeof(buf_str),
                   (char const *) format,
                                  v_args);
    va_end(v_args);

    BSP_Ser_WrStr((CPU_CHAR *)&buf_str[0]);
}


/*
*********************************************************************************************************
*                                                BSP_Ser_RdByte()
*
* Description : Receive a single byte.
*
* Argument(s) : none.
*
* Return(s)   : The received byte
*
* Caller(s)   : Application
*
* Note(s)     : (1) This functions blocks until a data is received.
*
*               (2) It can not be called from an ISR.
*********************************************************************************************************
*/

CPU_INT08U  BSP_Ser_RdByte (void)
{
    CPU_INT08U  rx_byte;


    BSP_OS_SemWait(&BSP_SerLock, 0);                            /* Obtain access to the serial interface              */

    rx_byte = BSP_Ser_RdByteUnlocked();

    BSP_OS_SemPost(&BSP_SerLock);                               /* Release access to the serial interface             */

    return (rx_byte);
}


/*
*********************************************************************************************************
*                                       BSP_Ser_RdByteUnlocked()
*
* Description : Receive a single byte.
*
* Argument(s) : none.
*
* Return(s)   : The received byte
*
* Caller(s)   : BSP_Ser_RdByte()
*               BSP_Ser_RdStr()
*
* Note(s)     : none.
*********************************************************************************************************
*/

CPU_INT08U  BSP_Ser_RdByteUnlocked (void)
{

    CPU_INT08U   rx_byte;


    USART_ITConfig(USART3, USART_IT_RXNE, ENABLE);              /* Enable the Receive not emptyt interrupt            */

    BSP_OS_SemWait(&BSP_SerRxWait, 0);                          /* Wait until a data is received                      */

    USART_ITConfig(USART3, USART_IT_RXNE, DISABLE);             /* Disable the Receive not empty interrupt            */

    rx_byte = BSP_SerRxData;                                    /* Read the data form the temporal register          */

    return (rx_byte);
}

/*
*********************************************************************************************************
*                                                BSP_Ser_RdStr()
*
* Description : This function reads a string from a UART.
*
* Argument(s) : p_str      A pointer to a buffer at which the string can be stored.
*
*               len         The size of the string that will be read.
*
* Return(s)   : none.
*
* Caller(s)   : Application
*
* Note(s)     : none.
*********************************************************************************************************
*/

void  BSP_Ser_RdStr (CPU_CHAR    *p_str,
                     CPU_INT16U   len)
{
    CPU_CHAR     rx_data;
    CPU_CHAR     rx_buf_ix;
    CPU_BOOLEAN  err;


    rx_buf_ix = 0;
    p_str[0]  = 0;

    err = BSP_OS_SemWait(&BSP_SerLock, 0);                      /* Obtain access to the serial interface              */

    if (err != DEF_OK ) {
        return;
    }

    while (DEF_TRUE)
    {
        rx_data = BSP_Ser_RdByteUnlocked();

        if ((rx_data == ASCII_CHAR_CARRIAGE_RETURN) ||          /* Is it '\r' or '\n' character  ?                    */
            (rx_data == ASCII_CHAR_LINE_FEED      )) {

            BSP_Ser_WrByteUnlocked((CPU_INT08U)ASCII_CHAR_LINE_FEED);
            BSP_Ser_WrByteUnlocked((CPU_INT08U)ASCII_CHAR_CARRIAGE_RETURN);

            p_str[rx_buf_ix] = 0;                              /* set the null character at the end of the string     */
            break;                                             /* exit the loop                                       */
        }

        if (rx_data == ASCII_CHAR_BACKSPACE) {                 /* Is backspace character                              */
            if (rx_buf_ix > 0) {
                BSP_Ser_WrByteUnlocked((CPU_INT08U)ASCII_CHAR_BACKSPACE);
                BSP_Ser_WrByteUnlocked((CPU_INT08U)ASCII_CHAR_SPACE);
                BSP_Ser_WrByteUnlocked((CPU_INT08U)ASCII_CHAR_BACKSPACE);

                rx_buf_ix--;                                   /* Decrement the index                                 */
                p_str[rx_buf_ix] = 0;
            }
        }

        if (ASCII_IsPrint(rx_data)) {                           /* Is it a printable character ... ?                  */
            BSP_Ser_WrByteUnlocked((CPU_INT08U)rx_data);        /* Echo-back                                          */
            p_str[rx_buf_ix] = rx_data;                         /* Save the received character in the buffer          */
            rx_buf_ix++;                                        /* Increment the buffer index                         */
            if (rx_buf_ix >= len) {
               rx_buf_ix = len;
            }
        }
    }

    BSP_OS_SemPost(&BSP_SerLock);                               /* Release access to the serial interface            */
}


/*
*********************************************************************************************************
*                                          BSP_Ser_WrByteUnlocked()
*
* Description : Writes a single byte to a serial port.
*
* Argument(s) : c    The character to output.
*
* Return(s)   : none.
*
* Caller(s)   : BSP_Ser_WrByte()
*               BSP_Ser_WrByteUnlocked()
*
* Note(s)     : (1) This function blocks until room is available in the UART for the byte to be sent.
*********************************************************************************************************
*/

void  BSP_Ser_WrByteUnlocked (CPU_INT08U c)
{

    USART_SendData(USART3, c);

    USART_ITConfig(USART3, USART_IT_TXE, ENABLE);
    BSP_OS_SemWait(&BSP_SerTxWait, 10);
    USART_ITConfig(USART3, USART_IT_TXE, DISABLE);
}


/*
*********************************************************************************************************
*                                                BSP_Ser_WrByte()
*
* Description : Writes a single byte to a serial port.
*
* Argument(s) : tx_byte     The character to output.
*
* Return(s)   : none.
*
* Caller(s)   : Application.
*
* Note(s)     : none.
*********************************************************************************************************
*/

void  BSP_Ser_WrByte(CPU_INT08U  c)
{
    BSP_OS_SemWait(&BSP_SerLock, 0);                            /* Obtain access to the serial interface              */

    BSP_Ser_WrByteUnlocked(c);

    BSP_OS_SemPost(&BSP_SerLock);                               /* Release access to the serial interface             */
}


/*
*********************************************************************************************************
*                                                BSP_Ser_WrStr()
*
* Description : Transmits a string.
*
* Argument(s) : p_str      Pointer to the string that will be transmitted
*
* Caller(s)   : Application
*
* Return(s)   : none.
*
* Note(s)     : none.
*********************************************************************************************************
*/

void  BSP_Ser_WrStr (CPU_CHAR  *p_str)
{
    CPU_BOOLEAN  err;

    err = BSP_OS_SemWait(&BSP_SerLock, 0);                      /* Obtain access to the serial interface              */

    if (err != DEF_OK ) {
        return;
    }

    while ((*p_str) != (CPU_CHAR )0) {

        if (*p_str == ASCII_CHAR_LINE_FEED) {
            BSP_Ser_WrByteUnlocked(ASCII_CHAR_CARRIAGE_RETURN);
            BSP_Ser_WrByteUnlocked(ASCII_CHAR_LINE_FEED);
            p_str++;
        } else {
            BSP_Ser_WrByteUnlocked(*p_str++);
        }
    }

    BSP_OS_SemPost(&BSP_SerLock);                               /* Release access to the serial interface             */
}
