355911097/gatewayapp/src/app/app.h

#ifndef  __APP_H__
#define  __APP_H__

/*
*********************************************************************************************************
*                                             INCLUDE FILES
*********************************************************************************************************
*/

#include  <includes.h>




#define START_TASK_PRIO			3
#define LED0_TASK_PRIO			5
#define LED1_TASK_PRIO			5
#define USART1_TASK_PRIO		5
#define USART3_TASK_PRIO		4
#define GPRS_INIT_TASK_PRIO		5
#define GPRS_RECV_TASK_PRIO		5
#define ETH_INIT_TASK_PRIO		5
#define DHCP_TASK_PRIO			5
#define RAWUDP_TASK_PRIO		5
#define PROTOCOL_TASK_PRIO		5
#define TRANSLATE_TASK_PRIO		5
















#endif
