355911097/gatewayapp/src/driver/sdio.h

#ifndef __SDIO_H__
#define __SDIO_H__


/*
*********************************************************************************************************
*                                              INCLUDE FILES
*********************************************************************************************************
*/
#include  <stdio.h>






#endif
