355911097/gatewayapp/(commit log)

2017-10-26 命名规则V1.0
2017-11-06 重新编译
2017-11-13 lwip
    ucosiii+lwip dhcp可以使用
2017-11-13 更改文件名
    udp_demo.c udp_demo.h 更改成rawudp.c rawudp.h
2017-12-13 Revert "t"
    This reverts commit cbdf3f0e3356332530ad9c834e3709c17a7e5ead.
    [gprs.c, protocol.c, protocol.h, usart.c, usart.h]
2017-12-13 Revert "Revert "t""
    This reverts commit 3e91c4a7709e03c00e0f8c972e243f27055aac70.
    [gprs.c, protocol.c, protocol.h, usart.c, usart.h]
2017-12-18 t
    gprs 接收任务创建
2017-12-22 添加网关物料
    [BM-ETH-IOT.xls, KS-WL-WG-04-01.xlsx, 新网关物料及状态表20170904.xlsx, 消防分类.xlsx, 采购申请单.xls]
2018-01-23 删除eth.c eth.h
